TechPaula/LT6502b/Images/PCB_MidAssembly.jpg

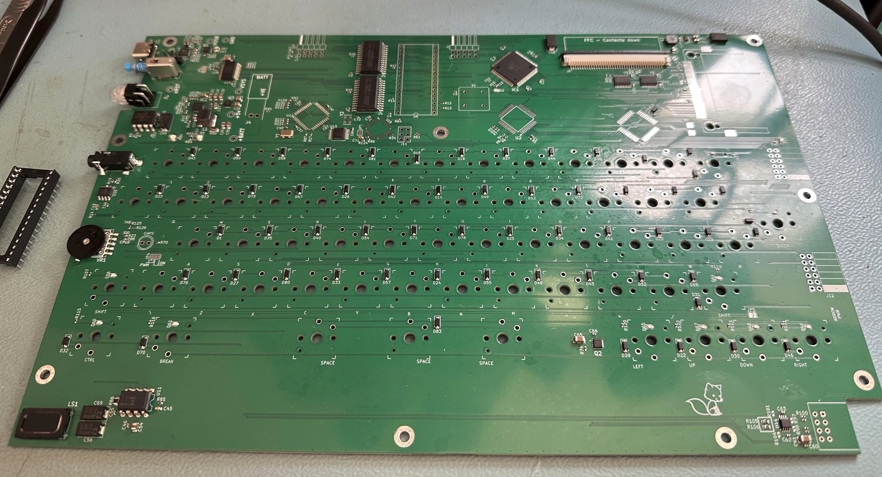
Images/PCB_MidAssembly.jpg
