TechPaula/LT6502b/Schematics/MainBoard/production/JLC_Selected_bom.xls

Comment | Designator | Footprint | JLCPCB Part #
3K3 | R1,R10,R100,R103,R16,R17,R18,R2,R21,R22,R25,R26,R27,R28,R3,R4,R5,R6,R64,R7,R8,R87,R92 | 0402 | C25890
47nF | C55 | 0402 | C82219
1K8 | R102,R91,R99 | 0402 | C25871
330R | R107,R115,R116,R117,R118,R119,R120,R121,R122,R123,R29 | 0402 | C25104
Conn_02x20_Odd_Even | J5 | GCT_FFC3B07-40-T | C501492
2.2uF25V | C27 | 0805 | C19110
10K | R108,R109,R11,R110,R111,R112,R113,R114,R12,R13,R37,R54,R57,R71,R72,R73,R82,R85,R93,R94 | 0402 | C25744
100K | R50,R74,R83 | 0402 | C25741
ECS-3961-200-AU-TR | Y1 | ECS3961200AUTR | C2451088
10K5 | R42,R43,R44,R45 | 0402 | C25850
220nF | C43 | 0603 | C21120
27K | R48 | 0402 | C2933084
100nF | C15,C1,C10,C11,C12,C13,C14,C18,C2,C28,C3,C35,C36,C37,C38,C39,C4,C40,C42,C44,C46,C47,C48,C49,C5,C50,C51,C52,C53,C6,C60,C62,C63,C64,C66,C67,C68,C7,C70,C72,C8,C9 | 0402 | C307331
POWERON | D11,D18 | 0805 | C2296
100uF10VTant | C56,C57,C58,C59,C69 | CP_EIA-7343-30_AVX-N | C49332976
10uF25V | C54,C16,C22,C29,C30,C31 | 0805 | C15850
TXS0108 | U8,U9 | TSSOP-20_4.4x6.5mm_P0.65mm | C17206
MP2636GR-P | IC2 | MP2636GR | C128212
TXS0102DCT | U14 | SSOP-8_2.95x2.8mm_P0.65mm | C324082
5K1 | R30,R31,R35,R36,R39 | 0402 | C25905
74HCT138 | U15 | SSOP-16_5.3x6.2mm_P0.65mm | C8115
10R | R86 | 0805 | C844598
1uF | C21,C24 | 0603 | C15849
ESDA25W | D3 | SOT65P210X110-3N | C2935152
22K | R53,R49 | 0402 | C25768
33nF | C45 | 0603 | C21117
22uF25V | C17,C19,C20,C25,C26,C33,C34 | 0805 | C45783
470p | C71 | 0603 | C1620
1N4148W | D1,D12,D13,D14,D15,D16,D20,D22,D23,D24,D25,D26,D27,D28,D29,D30,D31,D32,D33,D34,D35,D36,D37,D38,D39,D40,D41,D42,D43,D44,D45,D46,D47,D48,D49,D50,D51,D52,D53,D54,D55,D57,D58,D59,D69,D70,D71,D72,D73,D74,D75,D76,D77,D78,D79,D80,D81,D82,D83 | D_SOD-123 | C2099
470R | R15,R70,R81 | 0402 | C25117
2K49 | R52 | 0402 | C2692737
120K | R47 | 0402 | C25750
4K7 | R125,R69 | 0402 | C25900
0.1uF25VC0G | C23,C32 | 0603 | C91183
100R | R55 | 0402 | C25076
AP63203WU | U7 | TSOT-23-6 | C780769
LED | D2,D56,D60,D61,D62,D63,D64,D65,D66,D67,D68 | 0603 | C2286
CHARGE | D9 | 0805 | C84256
240k | R96 | 0402 | C2909338
44K2 | R41 | 0402 | C11565
4.7uH | L2 | NRS5020T220MMGJV | C2762047
BAT60A | D4 | D_SOD-323 | C5355496
1K | R19,R20,R58,R59,R60,R65,R66,R76,R77,R78,R79,R80,R9,R90 | 0402 | C11702
47uF | C41,C61,C65 | 1206 | C96123
47K | R23,R88 | 0402 | C25792
IS62C256AL | U3,U4 | SOP-28_8.4x18.16mm_P1.27mm | C14323
6K8 | R51,R84 | 0402 | C25917
STL9P3LLH6 | Q1,Q2,Q3 | STL20N6F7 | C2969828
40mR | R56 | 1206 | C2774938
15K | R40,R46 | 0402 | C25756
0R | R105,R106 | 0603 | C21189
1K | R33 | 0603 | C21190
STUSB4500QTR | U6 | QFN-24-1EP_4x4mm_P0.5mm_EP2.7x2.7mm | C2678061
