TechPaula/LT6502b/Schematics/Keybed/Assembly/Keybed_JLC_assembly_parts_bom.xls

Comment | Designator | Footprint | JLCPCB Part #
3K3 | R7 | 0603 | C22978
10K | R1 | 0603 | C25804
100nF | C1,C2,C4,C5,C8,C98,C99 | 0805 | C49678
1N4148W | D1,D10,D11,D12,D13,D14,D15,D16,D17,D18,D19,D2,D20,D21,D22,D23,D24,D25,D26,D27,D28,D29,D3,D30,D31,D32,D33,D34,D35,D36,D37,D38,D39,D4,D40,D41,D42,D43,D44,D45,D46,D47,D48,D49,D5,D50,D51,D52,D53,D54,D55,D57,D58,D59,D6,D7,D8,D9 | D_SOD-123 | C2099
47uF | C3,C6 | 1206 | C96123
470R | R2 | 0603 | C23179
74HCT138 | U2 | SSOP-16_5.3x6.2mm_P0.65mm | C8115
LED | D56,D60,D61,D62,D63,D64,D65,D66,D67,D68,D69 | 0603 | C2286
330R | R10,R11,R12,R13,R14,R3,R4,R5,R6,R8,R9 | 0603 | C23138
STL9P3LLH6 | Q3 | STL20N6F7 | C2969828
100K | R83 | 0402 | C25741
