TechPaula/LT6502b/Schematics/MainBoard/MainBoard_full_BoM.xls

Sheet: JLC FITTED
Comment | Designator | Footprint | QTY | JLCPCB Part #
3K3 | R1,R10,R100,R103,R16,R17,R18,R2,R21,R22,R25,R26,R27,R28,R3,R4,R5,R6,R64,R7,R8,R87,R92 | 0402 | 23 | C25890
47nF | C55 | 0402 | 1 | C82219
1K8 | R102,R91,R99 | 0402 | 3 | C25871
330R | R107,R115,R116,R117,R118,R119,R120,R121,R122,R123,R29 | 0402 | 11 | C25104
Conn_02x20_Odd_Even | J5 | GCT_FFC3B07-40-T | 1 | C501492
2.2uF25V | C27 | 0805 | 1 | C19110
10K | R108,R109,R11,R110,R111,R112,R113,R114,R12,R13,R37,R54,R57,R71,R72,R73,R82,R85,R93,R94 | 0402 | 20 | C25744
100K | R50,R74,R83 | 0402 | 3 | C25741
ECS-3961-200-AU-TR | Y1 | ECS3961200AUTR | 1 | C2451088
10K5 | R42,R43,R44,R45 | 0402 | 4 | C25850
220nF | C43 | 0603 | 1 | C21120
27K | R48 | 0402 | 1 | C2933084
100nF | C15,C1,C10,C11,C12,C13,C14,C18,C2,C28,C3,C35,C36,C37,C38,C39,C4,C40,C42,C44,C46,C47,C48,C49,C5,C50,C51,C52,C53,C6,C60,C62,C63,C64,C66,C67,C68,C7,C70,C72,C8,C9 | 0402 | 42 | C307331
POWERON | D11,D18 | 0805 | 2 | C2296
100uF10VTant | C56,C57,C58,C59,C69 | CP_EIA-7343-30_AVX-N | 5 | C49332976
10uF25V | C54,C16,C22,C29,C30,C31 | 0805 | 6 | C15850
TXS0108 | U8,U9 | TSSOP-20_4.4x6.5mm_P0.65mm | 2 | C17206
MP2636GR-P | IC2 | MP2636GR | 1 | C128212
TXS0102DCT | U14 | SSOP-8_2.95x2.8mm_P0.65mm | 1 | C324082
22K | R53,R49 | 0402 | 2 | C31850
5K1 | R30,R31,R35,R36,R39 | 0402 | 5 | C25905
74HCT138 | U15 | SSOP-16_5.3x6.2mm_P0.65mm | 1 | C8115
10R | R86 | 0805 | 1 | C844598
1uF | C21,C24 | 0603 | 2 | C15849
ESDA25W | D3 | SOT65P210X110-3N | 1 | C2935152
33nF | C45 | 0603 | 1 | C21117
22uF25V | C17,C19,C20,C25,C26,C33,C34 | 0805 | 7 | C45783
470p | C71 | 0603 | 1 | C1620
1N4148W | D1,D12,D13,D14,D15,D16,D20,D22,D23,D24,D25,D26,D27,D28,D29,D30,D31,D32,D33,D34,D35,D36,D37,D38,D39,D40,D41,D42,D43,D44,D45,D46,D47,D48,D49,D50,D51,D52,D53,D54,D55,D57,D58,D59,D69,D70,D71,D72,D73,D74,D75,D76,D77,D78,D79,D80,D81,D82,D83 | D_SOD-123 | 59 | C2099
470R | R15,R70,R81 | 0402 | 3 | C25117
2K49 | R52 | 0402 | 1 | C2692737
120K | R47 | 0402 | 1 | C25750
4K7 | R125,R69 | 0402 | 2 | C25900
0.1uF25VC0G | C23,C32 | 0603 | 2 | C91183
100R | R55 | 0402 | 1 | C25076
AP63203WU | U7 | TSOT-23-6 | 1 | C780769
LED | D2,D56,D60,D61,D62,D63,D64,D65,D66,D67,D68 | 0603 | 11 | C2286
CHARGE | D9 | 0805 | 1 | C84256
240k | R96 | 0402 | 1 | C2909338
44K2 | R41 | 0402 | 1 | C11565
4.7uH | L2 | NRS5020T220MMGJV | 1 | C2762047
BAT60A | D4 | D_SOD-323 | 1 | C5355496
1K | R19,R20,R58,R59,R60,R65,R66,R76,R77,R78,R79,R80,R9,R90 | 0402 | 14 | C11702
47uF | C41,C61,C65 | 1206 | 3 | C96123
47K | R23,R88 | 0402 | 2 | C25792
IS62C256AL | U3,U4 | SOP-28_8.4x18.16mm_P1.27mm | 2 | C14323
6K8 | R51,R84 | 0402 | 2 | C25917
STL9P3LLH6 | Q1,Q2,Q3 | STL20N6F7 | 3 | C2969828
40mR | R56 | 1206 | 1 | C2774938
15K | R40,R46 | 0402 | 2 | C25756
0R | R105,R106 | 0603 | 2 | C21189
1K | R33 | 0603 | 1 | C21190
STUSB4500QTR | U6 | QFN-24-1EP_4x4mm_P0.5mm_EP2.7x2.7mm | 1 | C2678061

Sheet: To Source
Designator | Description | Footprint | QTY | do I have? | MFR | MFR Part | Supplier | Supplier Part | Notes
U18 | ATmega88PA-AU | TQFP-32_7x7mm_P0.8mm | 1 | OO | Microchip | ATmega88PA-AU | AMI64 |  | NanoSwin SID
U12 | ATmega644P-20A | TQFP-44_10x10mm_P0.8mm | 1 | OO | Microchip | ATmega644P-20A
U10 | FT245RNL | SSOP-28_5.3x10.2mm_P0.65mm | 1 | 1 | FTDI | FT245RNL
U11 | LM386 | DIP-8_W7.62mm | 1 | 1 | TI | LM386N-4/NOPB
R124 | 2.2k | 0402 | 1 | 1
X1 | 28.4322MHz | Oscillator_DIP-8 | 1 | OO | ECS | ECS-2100AX-283.2
U16 | MCP6022 | SOIC-8_3.9x4.9mm_P1.27mm | 1 | OO | Microchip | MCP6022T-I/SN
Y2 | ECS-3961-320-AU-TR | ECS3961200AUTR | 1 | OO | ECS | ECS-3961-320-AU-TR
VR1 | RK10J12R0A0B | RK10J12R0A0B | 1 | 1 | Alps | RK10J12R0A0B
U13 | ESP8266-01_ESP-01 | XCVR_ESP8266-01_ESP-01 | 1 | 2 |  |  |  |  | ESP-01 (os ESP-01S) programmed with https://github.com/dhansel/WifiModem
U5 | SST39SF010A-70-4C-PHE | DIP-32 | 1 | OO | Microchip | SST39SF010A-70-4C-PHE |  |  | +Socket
D10 | Amber LED | LED_SMD:LED_0805_2012Metric | 1 | 1
D17 | Caps Lock LED | LED_THT:LED_D5.0mm | 1 | 1
IC1 | ATF1508AS-7AX100 | ATF1508ASL-nnAU100:QFP50P1600X1600X120-100N | 1 | 1 | Miceochip | ATF1508AS-7AX100 | Mouser | 556-AF1508AS7AX100
IC3 | W65C22S6TQG-14 | W65C22S6TQG-14:QFP80P1320X1320X270-44N | 1 | 1 | WDC | W65C22S6TQG-14 | Mouser | 955-W65C22S6TQG-14
J3 | USB_C_Receptacle_USB2.0_16P | Connector_USB:USB_C_Receptacle_HCTL_HC-TYPE-C-16P-01A | 1 | 1 | SameSky |  | Mouser
J4 | BATTERY JST PH-2A | S2B-XH-A_LF__SN_:SHDRRA2W80P0X250_1X2_740X1150X610P | 1 | OO |  |  | Mouser | 306-S2B-XH-ALFSN
J6 | AudioJack3 | Connector_Audio:Jack_3.5mm_CUI_SJ-3524-SMT_Horizontal | 1 | OO | SameSky | SJ-3524-SMT-TR | Mouser | 490-SJ-3524-SMT-TR
L1 | 1.5uH | SRN6045HA-1R5Y:INDPM6060X470N | 1 | 1 | Bournes | SRN6045HA-1R5Y | Mouser | 652-SRN6045HA-1R5Y
LS1 | CMS-160925-078SP-67 | CMS-160925-078SP-67:CMS160925078SP67 | 1 | 1 | Sky |  | Mouser | 490-CMS160925078SP67
R14, R32, R67, R68, R75, R95 | 0R 0402 | Resistor_SMD:R_0402_1005Metric | 6 | 6
R24, R61-R63 | 0R 0603 | Resistor_SMD:R_0603_1608Metric | 4 | 4
S1 | LC1258EENP |  | 1 | 1 | Eswitch | LC1258EENP | Mouser | 612-LC1258EENP | Power Switch
S2 | TL1250F180RQRCLR |  | 1 | 1 | Eswitch | TL1250F180RQRCLR | Mouser | 612-TL1250F180RQRCLR
SW1-SW55, SW57-SW61, SW65 | Kailh Choc Key switch |  | 61 | 9 |  |  |  |  | Also need suitable keycaps
U1 | TC1232 | Package_DIP:DIP-8_W7.62mm_LongPads | 1 | 1 | Microchip | TC1232 | Mouser | 579-TC1232CPA
U2 | W65C02S6TQG-14 | W65C22S6TQG-14:QFP80P1320X1320X270-44N | 1 | 1 | WDC | W65C02S6TQG-14 | Mouser | 955-W65C02S6TQG-14
J8 | Compact Flash connector |  | 1 | 1 |  | 693120035011 | Mouser | 598-693120035011
VR1 | Alps |  | 1 | 1 | Alps | RK10J12R0A0B | Mouser | 688-RK10J12R0A0B
