TechPaula/LT6502b/Case/Models/Lower Case V9.step

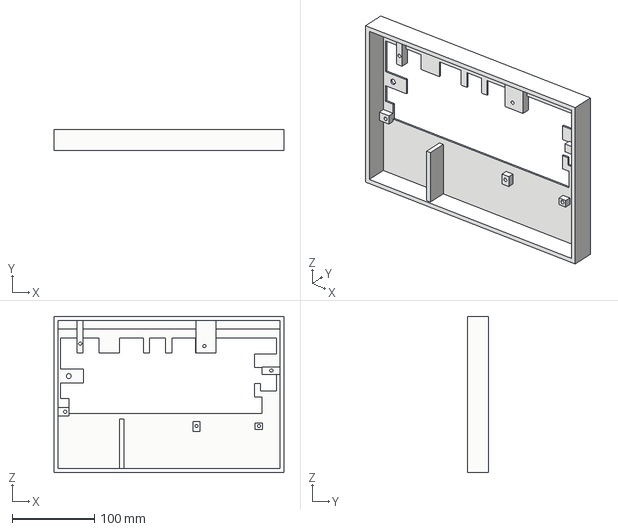
[picture p2: CAD file, 2026-02-22]
Case/Models/Lower Case V9.step
280.0 x 26.0 x 190.0 mm
