TechPaula/LT6502b/Case/Models/18650 Battery.STEP

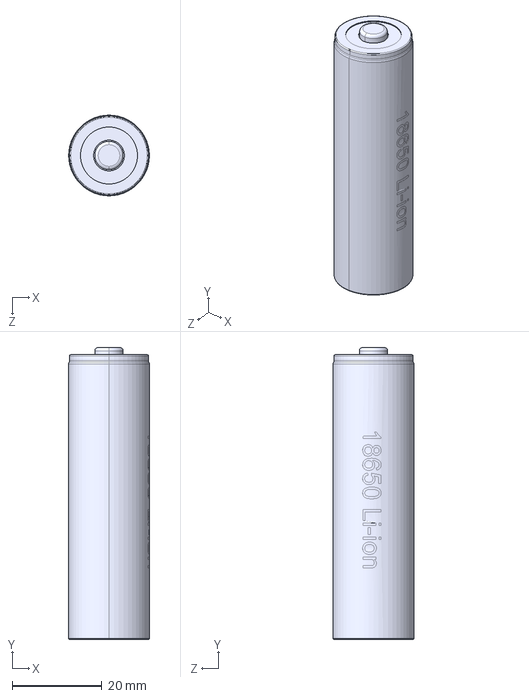
[picture p3: CAD file, 2026-02-22]
Case/Models/18650 Battery.STEP
18.0 x 65.1 x 18.0 mm
