TechPaula/LT6502b/Images/LT6502b_Assembly_2026-Feb-27.png

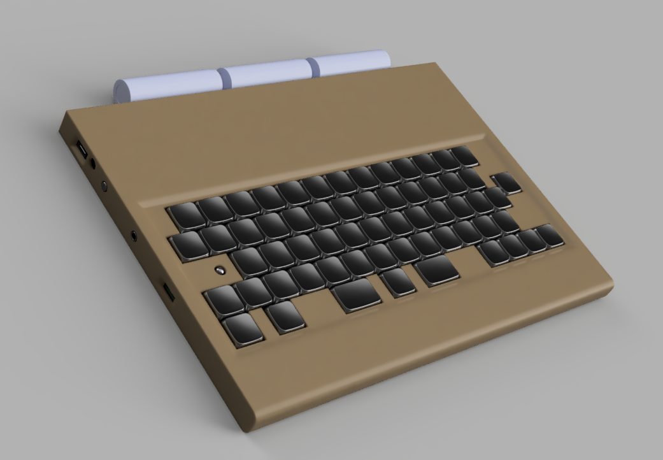
Images/LT6502b_Assembly_2026-Feb-27.png
