TechPaula/LT6502b/Images/LT6502b_Assembly_2026-Mar-07_08-01_noHinge.png

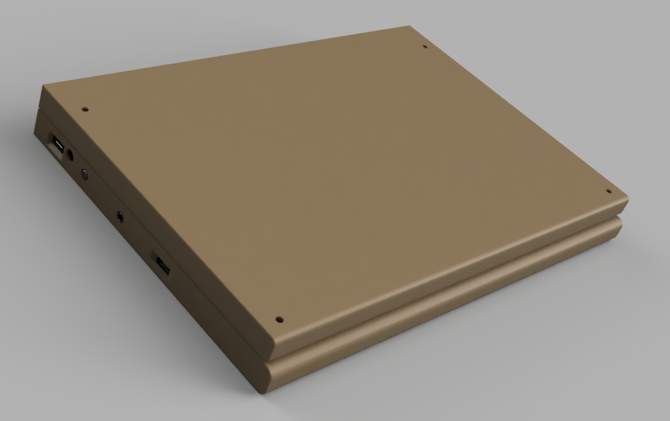
Images/LT6502b_Assembly_2026-Mar-07_08-01_noHinge.png
