TechPaula/LT6502b/Case/Dimensions for main PCB.pdf

1

A

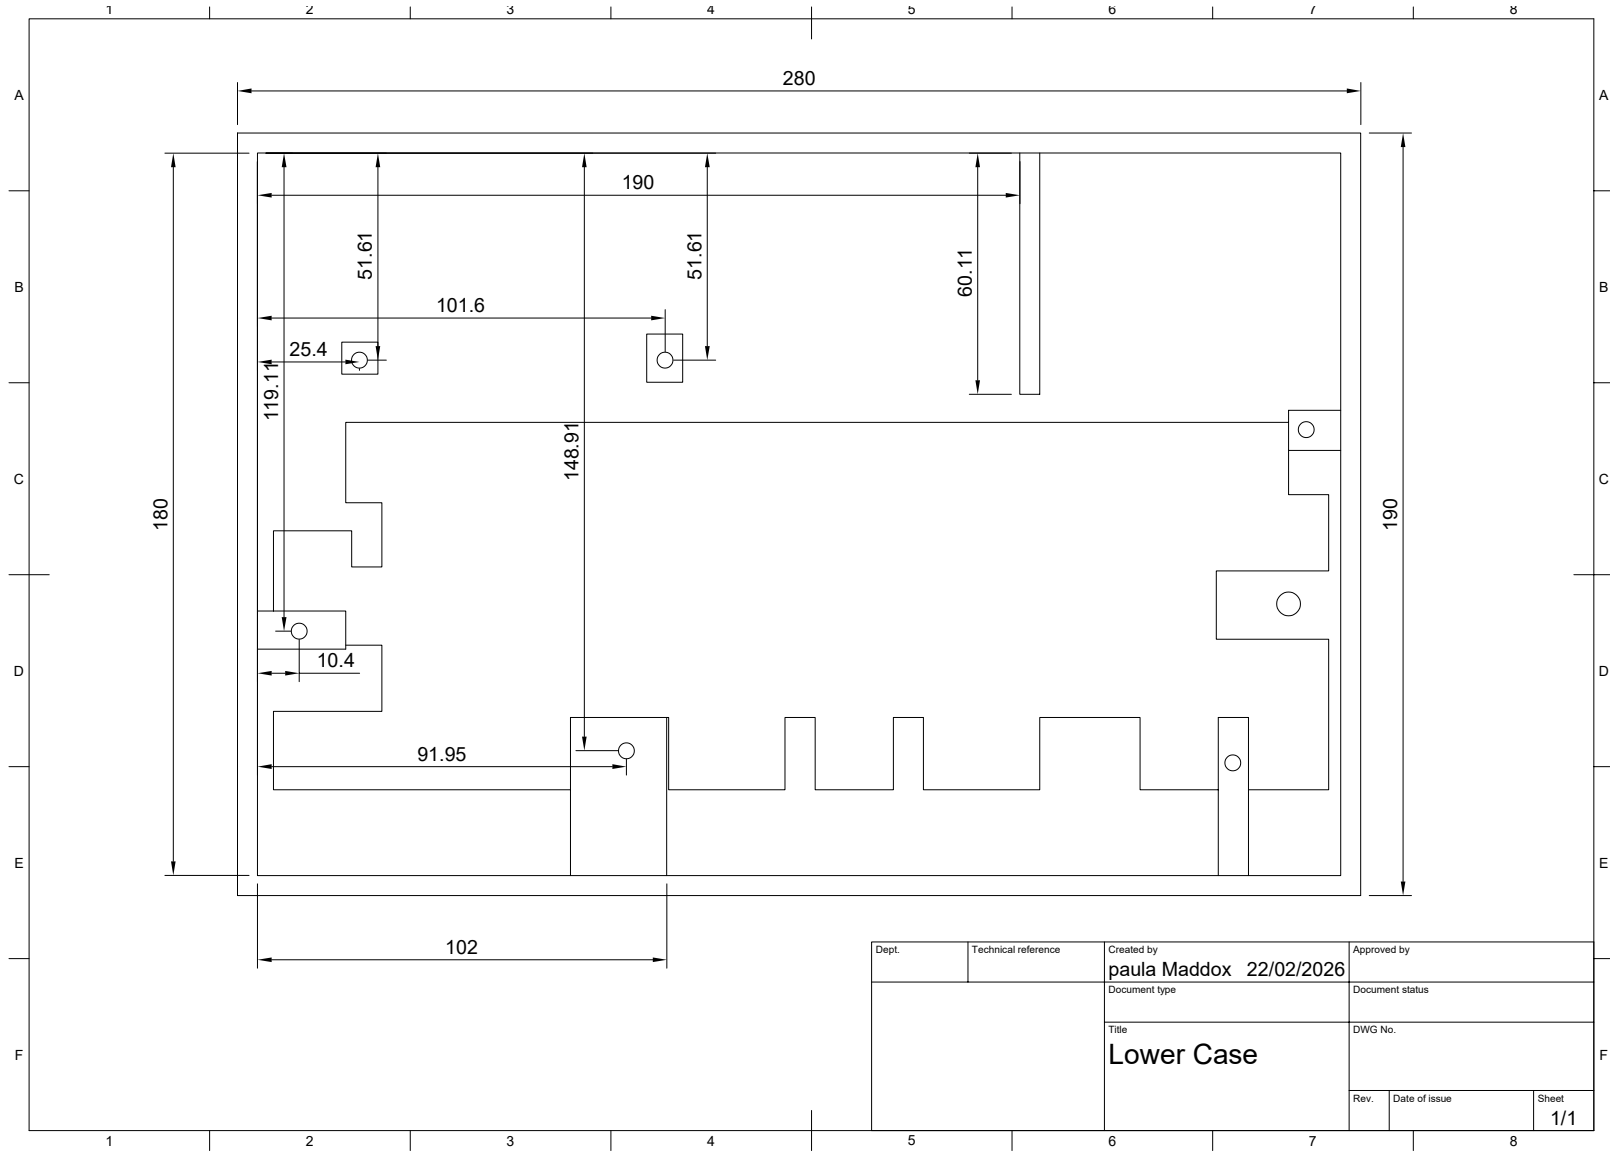
[picture p6: page 1]
Dept.; Technical reference; Created by; Approved by; Document type; Document status; Title; DWG No.; Rev.; Date of issue; Sheet; Lower Case; paula Maddox; 10.4 ¹¹⁹.11
