TechPaula/LT6502b/Schematics/MainBoard/MainBoard.kicad_pcb

## KiCad design Schematics/MainBoard/MainBoard.kicad_pcb (2026-02-24)

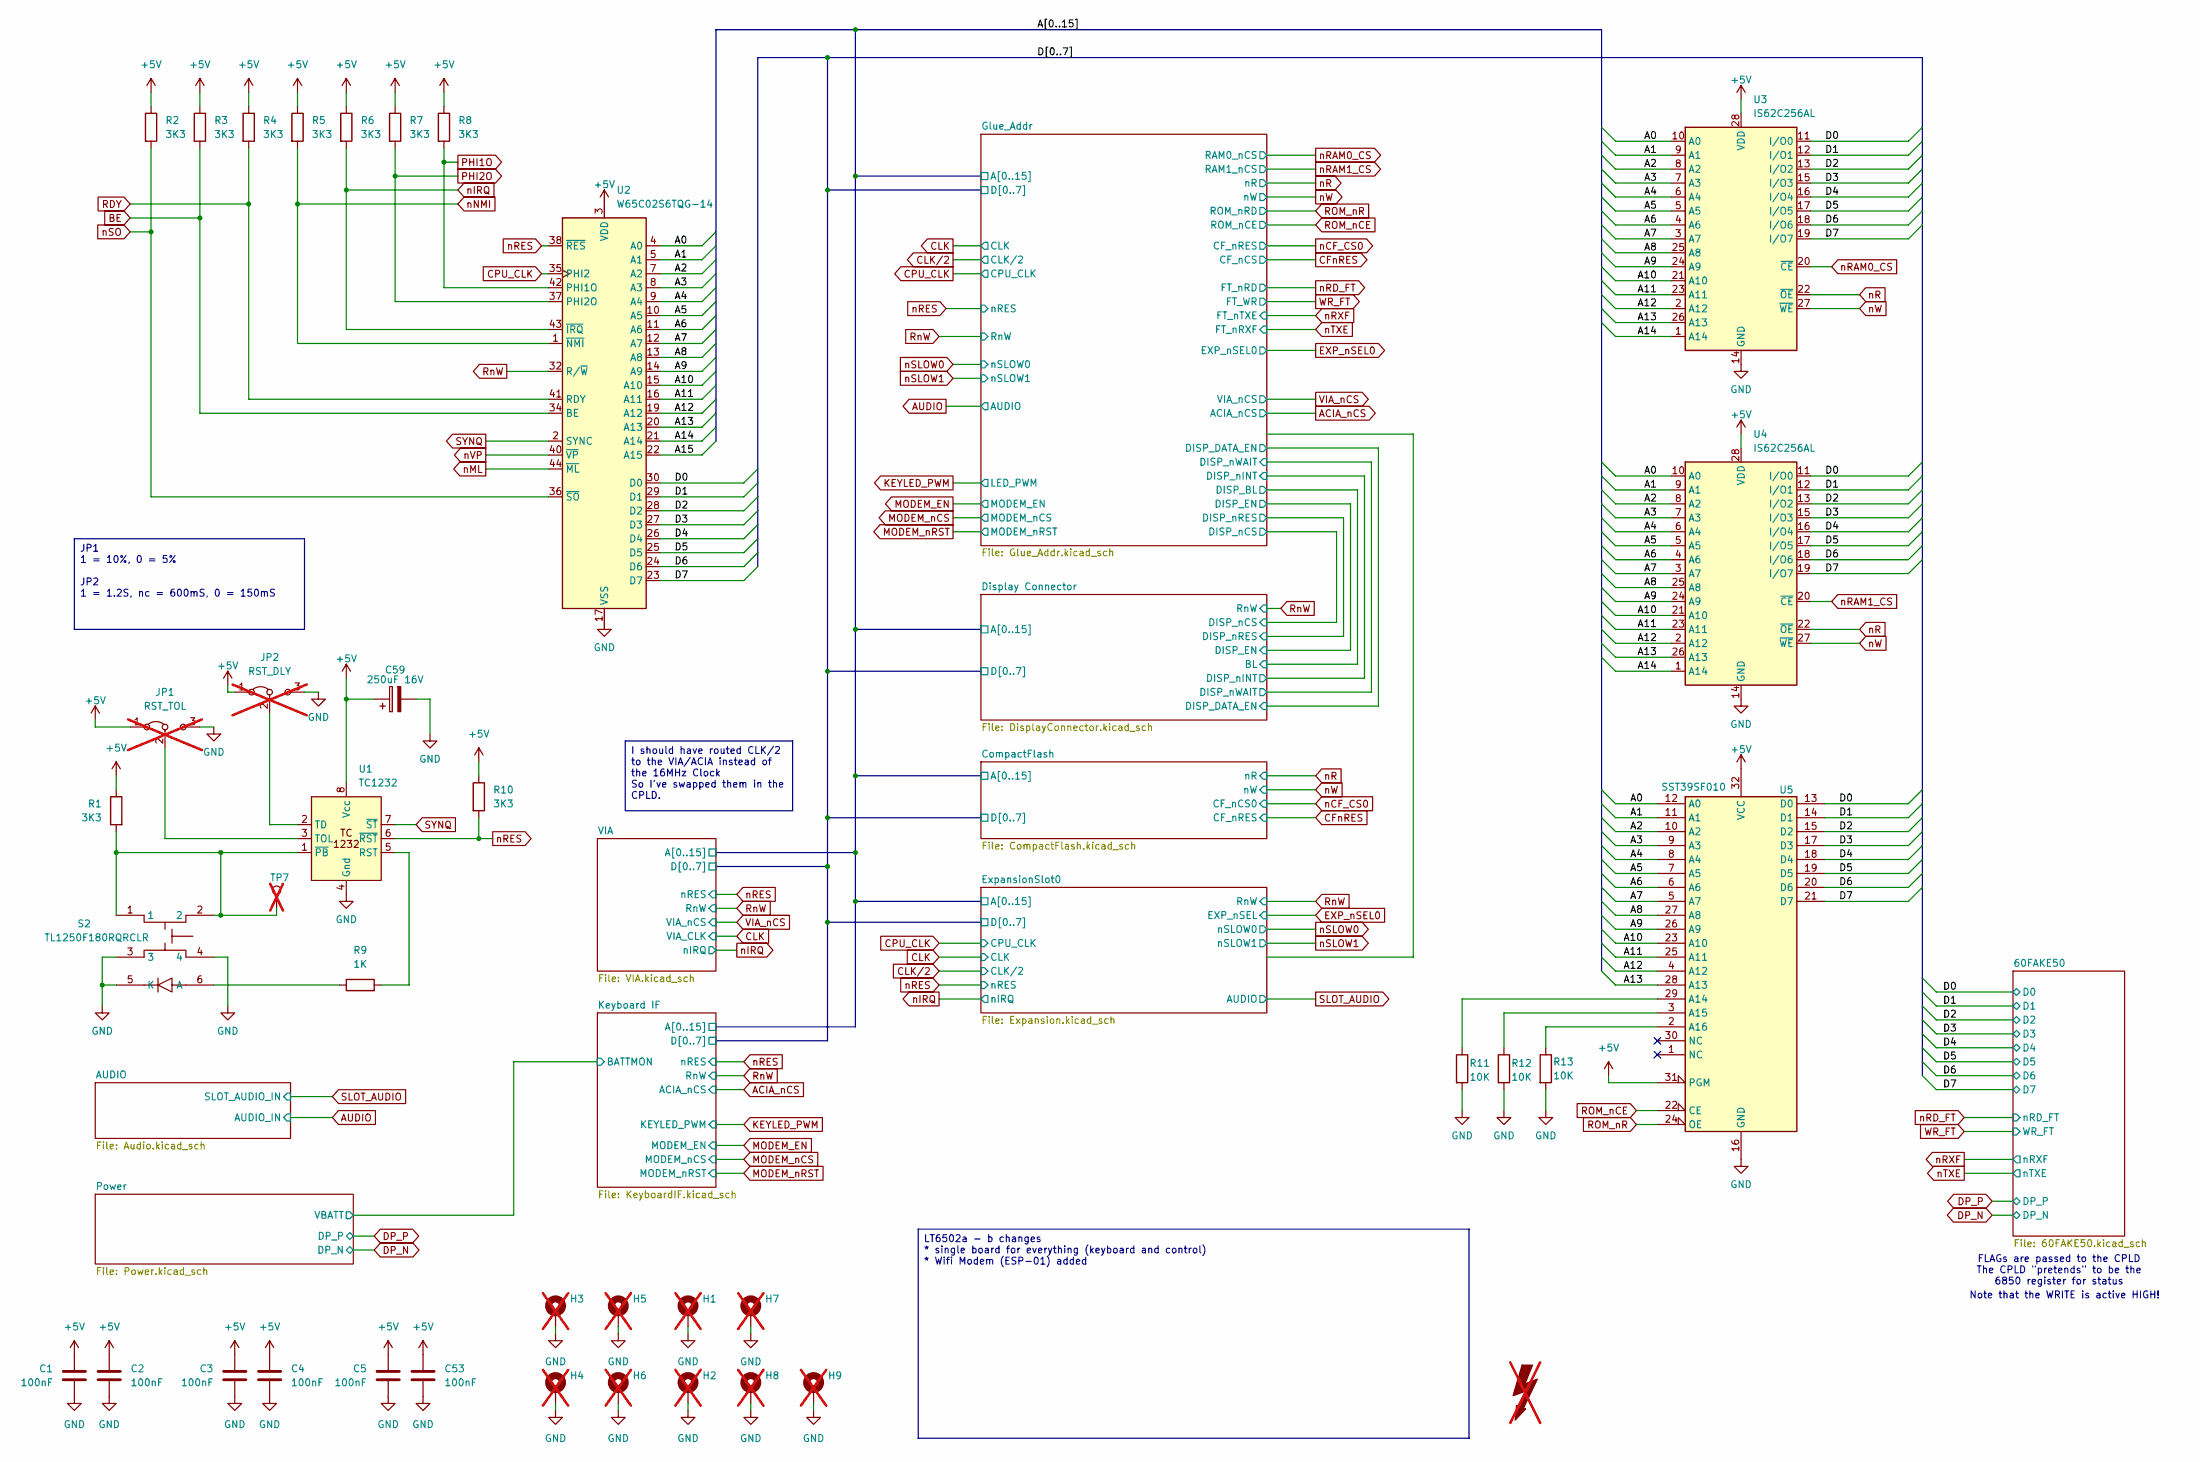
[picture p7: schematic MainBoard.kicad_sch]

Parts:
C1, C2, C3, C4, C5, C53: 100nF; C_0603_1608Metric; LCSC C113803
C59: 250uF 16V; CP_Elec_10x12.5; Mouser Part Number 667-EEV-FK1V681Q
FOX1: SYM_Flash_Large; Fox_avatar_18mm; LCSC DNF; not fitted
H1, H2, H3, H4, H5, H6, H7, H8, H9: MountingHole_Pad; MountingHole_3.2mm_M3_Pad_TopBottom; LCSC DNF; not fitted
JP1: RST_TOL; SolderJumper-3_P1.3mm_Bridged12_Pad1.0x1.5mm_NumberLabels; LCSC DNF; not fitted
JP2: RST_DLY; SolderJumper-3_P1.3mm_Bridged12_Pad1.0x1.5mm_NumberLabels; LCSC DNF; not fitted
R1, R2, R3, R4, R5, R6, R7, R8, R10: 3K3; R_0402_1005Metric; LCSC C25890
R9: 1K; R_0402_1005Metric; LCSC C11702
R11, R12, R13: 10K; R_0402_1005Metric; LCSC C25744
S2: TL1250F180RQRCLR; Mouser Part Number 612-TL1250F180RQRCLR
TP7: TestPoint; TestPoint_Loop_D1.80mm_Drill1.0mm_Beaded; LCSC DNF; not fitted
U1: TC1232; DIP-8_W7.62mm_LongPads; Mouser Part Number 579-TC1232CPA
U2: W65C02S6TQG-14; QFP80P1320X1320X270-44N; Mouser Part Number 955-W65C02S6TQG-14
U3, U4: IS62C256AL; SOP-28_8.4x18.16mm_P1.27mm; Mouser Part Number 870-62C256AL-25ULIT
U5: SST39SF010; DIP-32_W15.24mm_Socket; LCSC DNF

Connections:
+5V: C1.1, C2.1, C3.1, C4.1, C5.1, C53.1, C59.1, JP1.1 (A), JP2.1 (A), R1.1, R2.1, R3.1, R4.1, R5.1, R6.1, R7.1, R8.1, R10.1, U1.8 (Vcc), U2.3 (VDD), U2.31 (VDD), U3.28 (VDD), U4.28 (VDD), U5.31 (PGM), U5.32 (VCC); also elsewhere on the board
/A0: U2.4 (A0), U3.10 (A0), U4.10 (A0), U5.12 (A0); also elsewhere on the board
/A1: U2.5 (A1), U3.9 (A1), U4.9 (A1), U5.11 (A1); also elsewhere on the board
/A2: U2.7 (A2), U3.8 (A2), U4.8 (A2), U5.10 (A2); also elsewhere on the board
/A3: U2.8 (A3), U3.7 (A3), U4.7 (A3), U5.9 (A3); also elsewhere on the board
/A4: U2.9 (A4), U3.6 (A4), U4.6 (A4), U5.8 (A4); also elsewhere on the board
/A5: U2.10 (A5), U3.5 (A5), U4.5 (A5), U5.7 (A5); also elsewhere on the board
/A6: U2.11 (A6), U3.4 (A6), U4.4 (A6), U5.6 (A6); also elsewhere on the board
/A7: U2.12 (A7), U3.3 (A7), U4.3 (A7), U5.5 (A7); also elsewhere on the board
/A8: U2.13 (A8), U3.25 (A8), U4.25 (A8), U5.27 (A8); also elsewhere on the board
/A9: U2.14 (A9), U3.24 (A9), U4.24 (A9), U5.26 (A9); also elsewhere on the board
/A10: U2.15 (A10), U3.21 (A10), U4.21 (A10), U5.23 (A10); also elsewhere on the board
/A11: U2.16 (A11), U3.23 (A11), U4.23 (A11), U5.25 (A11); also elsewhere on the board
/A12: U2.19 (A12), U3.2 (A12), U4.2 (A12), U5.4 (A12); also elsewhere on the board
/A13: U2.20 (A13), U3.26 (A13), U4.26 (A13), U5.28 (A13); also elsewhere on the board
/A14: U2.21 (A14), U3.1 (A14), U4.1 (A14); also elsewhere on the board
/A15: U2.22 (A15); also elsewhere on the board
/D0: U2.30 (D0), U3.11 (I/O0), U4.11 (I/O0), U5.13 (D0); also elsewhere on the board
/D1: U2.29 (D1), U3.12 (I/O1), U4.12 (I/O1), U5.14 (D1); also elsewhere on the board
/D2: U2.28 (D2), U3.13 (I/O2), U4.13 (I/O2), U5.15 (D2); also elsewhere on the board
/D3: U2.27 (D3), U3.15 (I/O3), U4.15 (I/O3), U5.17 (D3); also elsewhere on the board
/D4: U2.26 (D4), U3.16 (I/O4), U4.16 (I/O4), U5.18 (D4); also elsewhere on the board
/D5: U2.25 (D5), U3.17 (I/O5), U4.17 (I/O5), U5.19 (D5); also elsewhere on the board
/D6: U2.24 (D6), U3.18 (I/O6), U4.18 (I/O6), U5.20 (D6); also elsewhere on the board
/D7: U2.23 (D7), U3.19 (I/O7), U4.19 (I/O7), U5.21 (D7); also elsewhere on the board
BE: R3.2, U2.34 (BE)
CPU_CLK: U2.35 (PHI2); also elsewhere on the board
GND: C1.2, C2.2, C3.2, C4.2, C5.2, C53.2, C59.2, H1.1, H2.1, H3.1, H4.1, H5.1, H6.1, H7.1, H8.1, H9.1, JP1.3 (B), JP2.3 (B), R11.2, R12.2, R13.2, S2.3, S2.4, S2.5 (K), U1.4 (Gnd), U2.17 (VSS), U2.18 (VSS), U2.39 (VSS), U3.14 (GND), U4.14 (GND), U5.16 (GND); also elsewhere on the board
unnamed: JP1.2 (C), U1.3 (TOL)
unnamed: JP2.2 (C), U1.2 (TD)
unnamed: R9.1, S2.6 (A)
unnamed: R9.2, U1.5 (RST)
unnamed: R1.2, S2.1, S2.2, TP7.1, U1.1 (~PB)
unnamed: R11.1, U5.29 (A14)
unnamed: R12.1, U5.3 (A15)
unnamed: R13.1, U5.2 (A16)
PHI1O: R8.2, U2.42 (PHI1O)
PHI2O: R7.2, U2.37 (PHI2O)
RDY: R4.2, U2.41 (RDY)
ROM_nCE: U5.22 (CE); also elsewhere on the board
ROM_nR: U5.24 (OE); also elsewhere on the board
RnW: U2.32 (R/~W); also elsewhere on the board
SYNQ: U1.7 (~ST), U2.2 (SYNC)
nIRQ: R6.2, U2.43 (~IRQ); also elsewhere on the board
nML: U2.44 (~ML)
nNMI: R5.2, U2.1 (~NMI)
nR: U3.22 (~OE), U4.22 (~OE); also elsewhere on the board
nRAM0_CS: U3.20 (~CE); also elsewhere on the board
nRAM1_CS: U4.20 (~CE); also elsewhere on the board
nRES: R10.2, U1.6 (~RST), U2.38 (~RES); also elsewhere on the board
nSO: R2.2, U2.36 (~SO)
nVP: U2.40 (~VP)
nW: U3.27 (~WE), U4.27 (~WE); also elsewhere on the board

Notes on the sheet:
FLAGs are passed to the CPLD The CPLD "pretends" to be the 6850 register for status
Note that the WRITE is active HIGH!
JP1 1 = 10%, 0 = 5% JP2 1 = 1.2S, nc = 600mS, 0 = 150mS
I should have routed CLK/2 to the VIA/ACIA instead of the 16MHz Clock So I've swapped them in the CPLD.
LT6502a - b changes * single board for everything (keyboard and control) * Wifi Modem (ESP-01) added

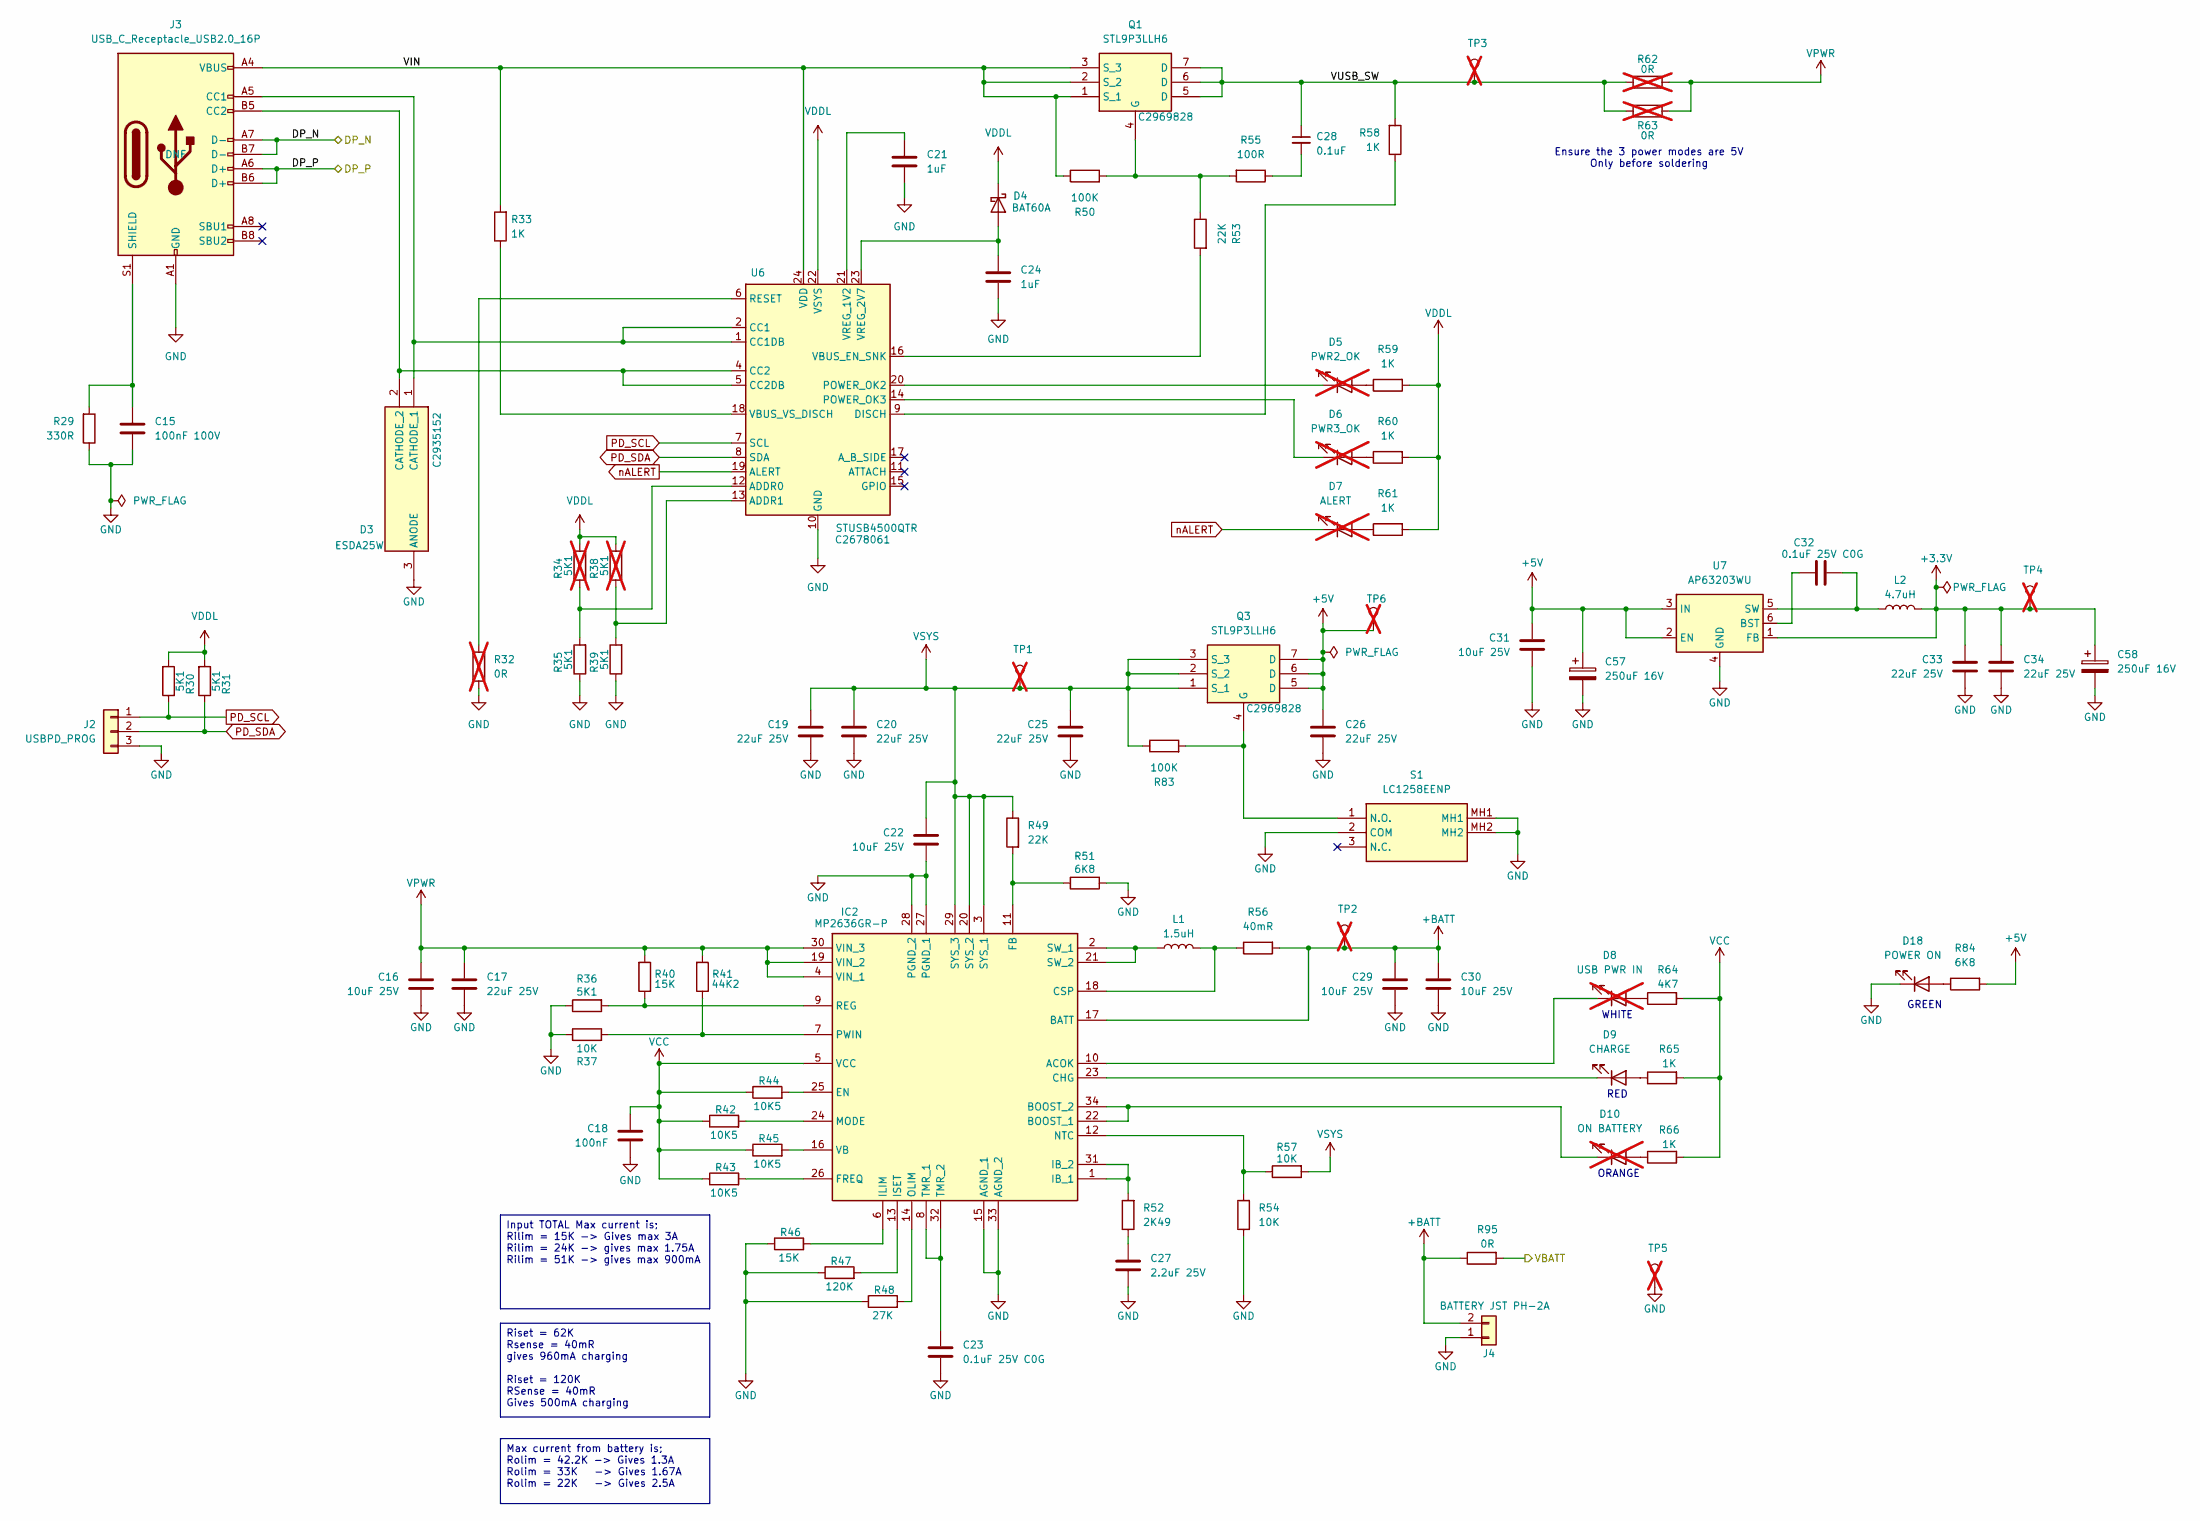
[picture p8: schematic Power.kicad_sch]

Parts:
C15: 100nF 100V; C_0603_1608Metric; LCSC C113803
C16, C22, C29, C30, C31: 10uF 25V; C_0805_2012Metric; LCSC C15850
C17, C19, C20, C25, C26, C33, C34: 22uF 25V; C_0805_2012Metric; LCSC C45783
C18: 100nF; C_0603_1608Metric; LCSC C113803
C21, C24: 1uF; C_0603_1608Metric; LCSC C15849
C23, C32: 0.1uF 25V C0G; C_0603_1608Metric; LCSC C91183
C27: 2.2uF 25V; C_0805_2012Metric; LCSC C19110
C28: 0.1uF; C_0603_1608Metric; LCSC C113803
C57, C58: 250uF 16V; CP_Elec_10x12.5; Mouser Part Number 667-EEV-FK1V681Q
D3: ESDA25W; SOT65P210X110-3N; Mouser Part Number 511-ESDA25W
D4: BAT60A; D_SOD-323; LCSC C5355496
D5: PWR2_OK; LED_0603_1608Metric; LCSC DNF; not fitted
D6: PWR3_OK; LED_0603_1608Metric; LCSC DNF; not fitted
D7: ALERT; LED_0603_1608Metric; LCSC DNF; not fitted
D8: USB PWR IN; LED_0805_2012Metric; LCSC DNF; not fitted
D9: CHARGE; LED_0805_2012Metric; LCSC DNF
D10: ON BATTERY; LED_0805_2012Metric; LCSC DNF; not fitted
D18: POWER ON; LED_0805_2012Metric; LCSC DNF
IC2: MP2636GR-P; MP2636GR; Mouser Part Number 946-MP2636GR-P
J2: USBPD_PROG; PinHeader_1x03_P2.54mm_Vertical; LCSC DNF
J3: USB_C_Receptacle_USB2.0_16P; USB_C_Receptacle_HCTL_HC-TYPE-C-16P-01A; LCSC DNF
J4: BATTERY JST PH-2A; SHDRRA2W80P0X250_1X2_740X1150X610P; Mouser Part Number 306-S2B-XH-ALFSN
L1: 1.5uH; INDPM6060X470N; Mouser Part Number 652-SRN6045HA-1R5Y
L2: 4.7uH; NRS5020T220MMGJV; Mouser Part Number 963-NRS5020T4R7MMGJ
Q1, Q3: STL9P3LLH6; STL20N6F7; Manufacturer_Part_Number STL9P3LLH6; Mouser Part Number 511-STL9P3LLH6
R29: 330R; R_0402_1005Metric; LCSC C25104
R30, R31, R35, R36, R39: 5K1; R_0402_1005Metric; LCSC C25905
R32: 0R; R_0402_1005Metric; LCSC DNF; not fitted
R33, R58, R59, R60, R61, R65, R66: 1K; R_0402_1005Metric; LCSC C11702
R34, R38: 5K1; R_0402_1005Metric; LCSC C25905; not fitted
R37, R54, R57: 10K; R_0402_1005Metric; LCSC C25744
R40: 15K; R_0402_1005Metric; LCSC C25756
R41: 44K2; R_0402_1005Metric; LCSC C11565
R42, R43, R44, R45: 10K5; R_0402_1005Metric; LCSC C25850
R46: 15K; R_0402_1005Metric; LCSC ???
R47: 120K; R_0402_1005Metric; LCSC ???
R48: 27K; R_0402_1005Metric
R49, R53: 22K; R_0402_1005Metric; LCSC C25768
R50, R83: 100K; R_0402_1005Metric; LCSC C25741
R51: 6K8; R_0402_1005Metric; LCSC C25917
R52: 2K49; R_0402_1005Metric; LCSC C2692737
R55: 100R; R_0402_1005Metric; LCSC C25076
R56: 40mR; R_1206_3216Metric; LCSC C2774938
R62, R63: 0R; R_0603_1608Metric; LCSC DNF; not fitted
R64: 4K7; R_0402_1005Metric
R84: 6K8; R_0402_1005Metric
R95: 0R; R_0402_1005Metric
S1: LC1258EENP; Mouser Part Number 612-LC1258EENP
TP1, TP2, TP3, TP4, TP5, TP6: TestPoint; TestPoint_Loop_D1.80mm_Drill1.0mm_Beaded; LCSC DNF; not fitted
U6: STUSB4500QTR; QFN-24-1EP_4x4mm_P0.5mm_EP2.7x2.7mm; LCSC C2678061
U7: AP63203WU; TSOT-23-6; Mouser Part Number 621-AP63203WU-7

Connections:
+3.3V: C33.1, C34.1, C58.1, L2.2, TP4.1, U7.1 (FB); also elsewhere on the board
+5V: C26.1, C31.1, C57.1, Q3.5 (D), Q3.6 (D), Q3.7 (D), R84.2, TP6.1, U7.2 (EN), U7.3 (IN); also elsewhere on the board
+BATT: C29.1, C30.1, IC2.17 (BATT), J4.2, R56.2, R95.1, TP2.1
/Keyboard IF/BATTMON: R95.2; also elsewhere on the board
/Power/VIN: J3.A4 (VBUS), J3.A9 (VBUS), J3.B4 (VBUS), J3.B9 (VBUS), Q1.1 (S_1), Q1.2 (S_2), Q1.3 (S_3), R33.2, R50.1, U6.24 (VDD)
/Power/VUSB_SW: C28.1, Q1.5 (D), Q1.6 (D), Q1.7 (D), R58.2, R62.1, R63.1, TP3.1
DP_N: J3.A7 (D-), J3.B7 (D-); also elsewhere on the board
DP_P: J3.A6 (D+), J3.B6 (D+); also elsewhere on the board
GND: C15.2, C16.2, C17.2, C18.2, C19.2, C20.2, C21.2, C22.2, C23.2, C24.2, C25.2, C26.2, C27.2, C29.2, C30.2, C31.2, C33.2, C34.2, C57.2, C58.2, D3.3 (ANODE), D18.1 (K), IC2.15 (AGND_1), IC2.27 (PGND_1), IC2.28 (PGND_2), IC2.33 (AGND_2), J2.3, J3.A1 (GND), J3.A12 (GND), J3.B1 (GND), J3.B12 (GND), J4.1, R29.1, R32.1, R35.1, R36.1, R37.1, R39.1, R46.1, R47.1, R48.1, R51.2, R54.1, S1.2 (COM), S1.MH1, S1.MH2, TP5.1, U6.10 (GND), U6.25 (GND), U7.4 (GND); also elsewhere on the board
unnamed: C27.1, R52.1
unnamed: C28.2, R55.1
unnamed: D3.1 (CATHODE_1), J3.A5 (CC1), U6.1 (CC1DB), U6.2 (CC1)
unnamed: D3.2 (CATHODE_2), J3.B5 (CC2), U6.4 (CC2), U6.5 (CC2DB)
unnamed: C24.1, D4.2 (A), U6.23 (VREG_2V7)
unnamed: D5.2 (A), R59.1
unnamed: D5.1 (K), U6.20 (POWER_OK2)
unnamed: D6.2 (A), R60.1
unnamed: D6.1 (K), U6.14 (POWER_OK3)
unnamed: D7.2 (A), R61.1
unnamed: D8.2 (A), R64.1
unnamed: D8.1 (K), IC2.10 (ACOK)
unnamed: D9.2 (A), R65.1
unnamed: D9.1 (K), IC2.23 (CHG)
unnamed: D10.2 (A), R66.1
unnamed: D10.1 (K), IC2.22 (BOOST_1), IC2.34 (BOOST_2)
unnamed: D18.2 (A), R84.1
unnamed: IC2.18 (CSP), L1.2, R56.1
unnamed: IC2.25 (EN), R44.2
unnamed: IC2.11 (FB), R49.2, R51.1
unnamed: IC2.26 (FREQ), R43.2
unnamed: IC2.1 (IB_1), IC2.31 (IB_2), R52.2
unnamed: IC2.6 (ILIM), R46.2
unnamed: IC2.13 (ISET), R47.2
unnamed: IC2.24 (MODE), R42.2
unnamed: IC2.12 (NTC), R54.2, R57.1
unnamed: IC2.14 (OLIM), R48.2
unnamed: IC2.7 (PWIN), R37.2, R41.1
unnamed: IC2.9 (REG), R36.2, R40.1
unnamed: IC2.2 (SW_1), IC2.21 (SW_2), L1.1
unnamed: C23.1, IC2.8 (TMR_1), IC2.32 (TMR_2)
unnamed: IC2.16 (VB), R45.2
unnamed: C15.1, J3.S1 (SHIELD), R29.2
unnamed: Q1.4 (G), R50.2, R53.1, R55.2
unnamed: Q3.4 (G), R83.2, S1.1 (N.O.)
unnamed: R34.1, R35.2, U6.12 (ADDR0)
unnamed: R38.1, R39.2, U6.13 (ADDR1)
unnamed: R58.1, U6.9 (DISCH)
unnamed: R32.2, U6.6 (RESET)
unnamed: R53.2, U6.16 (VBUS_EN_SNK)
unnamed: R33.1, U6.18 (VBUS_VS_DISCH)
unnamed: C21.1, U6.21 (VREG_1V2)
unnamed: C32.1, U7.6 (BST)
unnamed: C32.2, L2.1, U7.5 (SW)
PD_SCL: J2.1, R30.1, U6.7 (SCL)
PD_SDA: J2.2, R31.1, U6.8 (SDA)
VCC: C18.1, IC2.5 (VCC), R42.1, R43.1, R44.1, R45.1, R64.2, R65.2, R66.2
VPWR: C16.1, C17.1, IC2.4 (VIN_1), IC2.19 (VIN_2), IC2.30 (VIN_3), R40.2, R41.2, R62.2, R63.2; also elsewhere on the board
VSYS: C19.1, C20.1, C22.1, C25.1, IC2.3 (SYS_1), IC2.20 (SYS_2), IC2.29 (SYS_3), Q3.1 (S_1), Q3.2 (S_2), Q3.3 (S_3), R49.1, R57.2, R83.1, TP1.1
nALERT: D7.1 (K), U6.19 (ALERT)

Notes on the sheet:
Ensure the 3 power modes are 5V Only before soldering
ORANGE
RED
GREEN
WHITE
Input TOTAL Max current is; Rilim = 15K -> Gives max 3A Rilim = 24K -> gives max 1.75A Rilim = 51K -> gives max 900mA
Riset = 62K Rsense = 40mR gives 960mA charging Riset = 120K RSense = 40mR Gives 500mA charging
Max current from battery is; Rolim = 42.2K -> Gives 1.3A Rolim = 33K -> Gives 1.67A Rolim = 22K -> Gives 2.5A

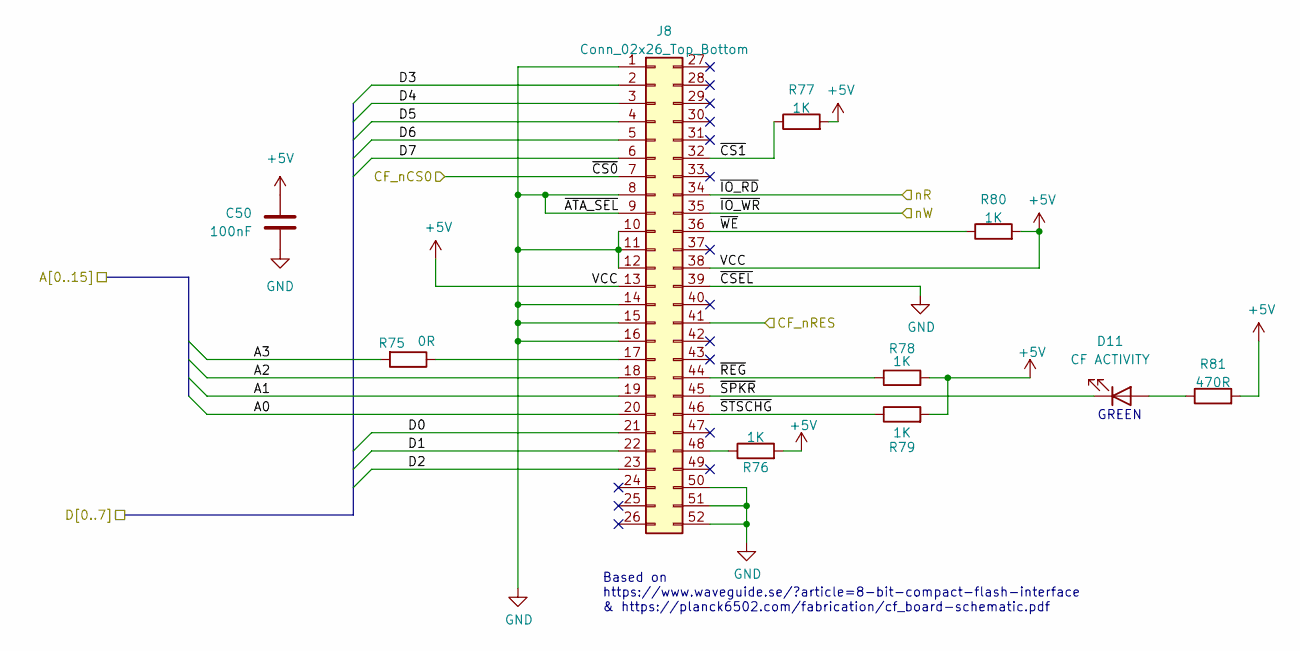
[picture p9: schematic CompactFlash.kicad_sch]

Parts:
C50: 100nF; C_0603_1608Metric; LCSC C113803
D11: CF ACTIVITY; LED_0805_2012Metric; LCSC DNF
J8: Conn_02x26_Top_Bottom; SD-SMD_CFH-L3C1LBL01MN0; Mouser Part Number 710-693120035011; LCSC DNF
R75: 0R; R_0402_1005Metric; LCSC DNF
R76, R77, R78, R79, R80: 1K; R_0402_1005Metric; LCSC C11702
R81: 470R; R_0402_1005Metric; LCSC C25117

Connections:
+5V: C50.1, J8.13, J8.38, R76.2, R77.2, R78.2, R79.2, R80.2, R81.2; also elsewhere on the board
/A0: J8.20; also elsewhere on the board
/A1: J8.19; also elsewhere on the board
/A2: J8.18; also elsewhere on the board
/A3: R75.2; also elsewhere on the board
/CompactFlash/~CS1: J8.32, R77.1
/CompactFlash/~REG: J8.44, R78.1
/CompactFlash/~SPKR: D11.1 (K), J8.45
/CompactFlash/~STSCHG: J8.46, R79.1
/CompactFlash/~WE: J8.36, R80.1
/D0: J8.21; also elsewhere on the board
/D1: J8.22; also elsewhere on the board
/D2: J8.23; also elsewhere on the board
/D3: J8.2; also elsewhere on the board
/D4: J8.3; also elsewhere on the board
/D5: J8.4; also elsewhere on the board
/D6: J8.5; also elsewhere on the board
/D7: J8.6; also elsewhere on the board
CFnRES: J8.41; also elsewhere on the board
GND: C50.2, J8.1, J8.8, J8.9, J8.10, J8.11, J8.12, J8.14, J8.15, J8.16, J8.39, J8.50, J8.51, J8.52; also elsewhere on the board
unnamed: D11.2 (A), R81.1
unnamed: J8.17, R75.1
unnamed: J8.48, R76.1
nCF_CS0: J8.7; also elsewhere on the board
nR: J8.34; also elsewhere on the board
nW: J8.35; also elsewhere on the board

Notes on the sheet:
GREEN
Based on https://www.waveguide.se/?article=8-bit-compact-flash-interface & https://planck6502.com/fabrication/cf_board-schematic.pdf

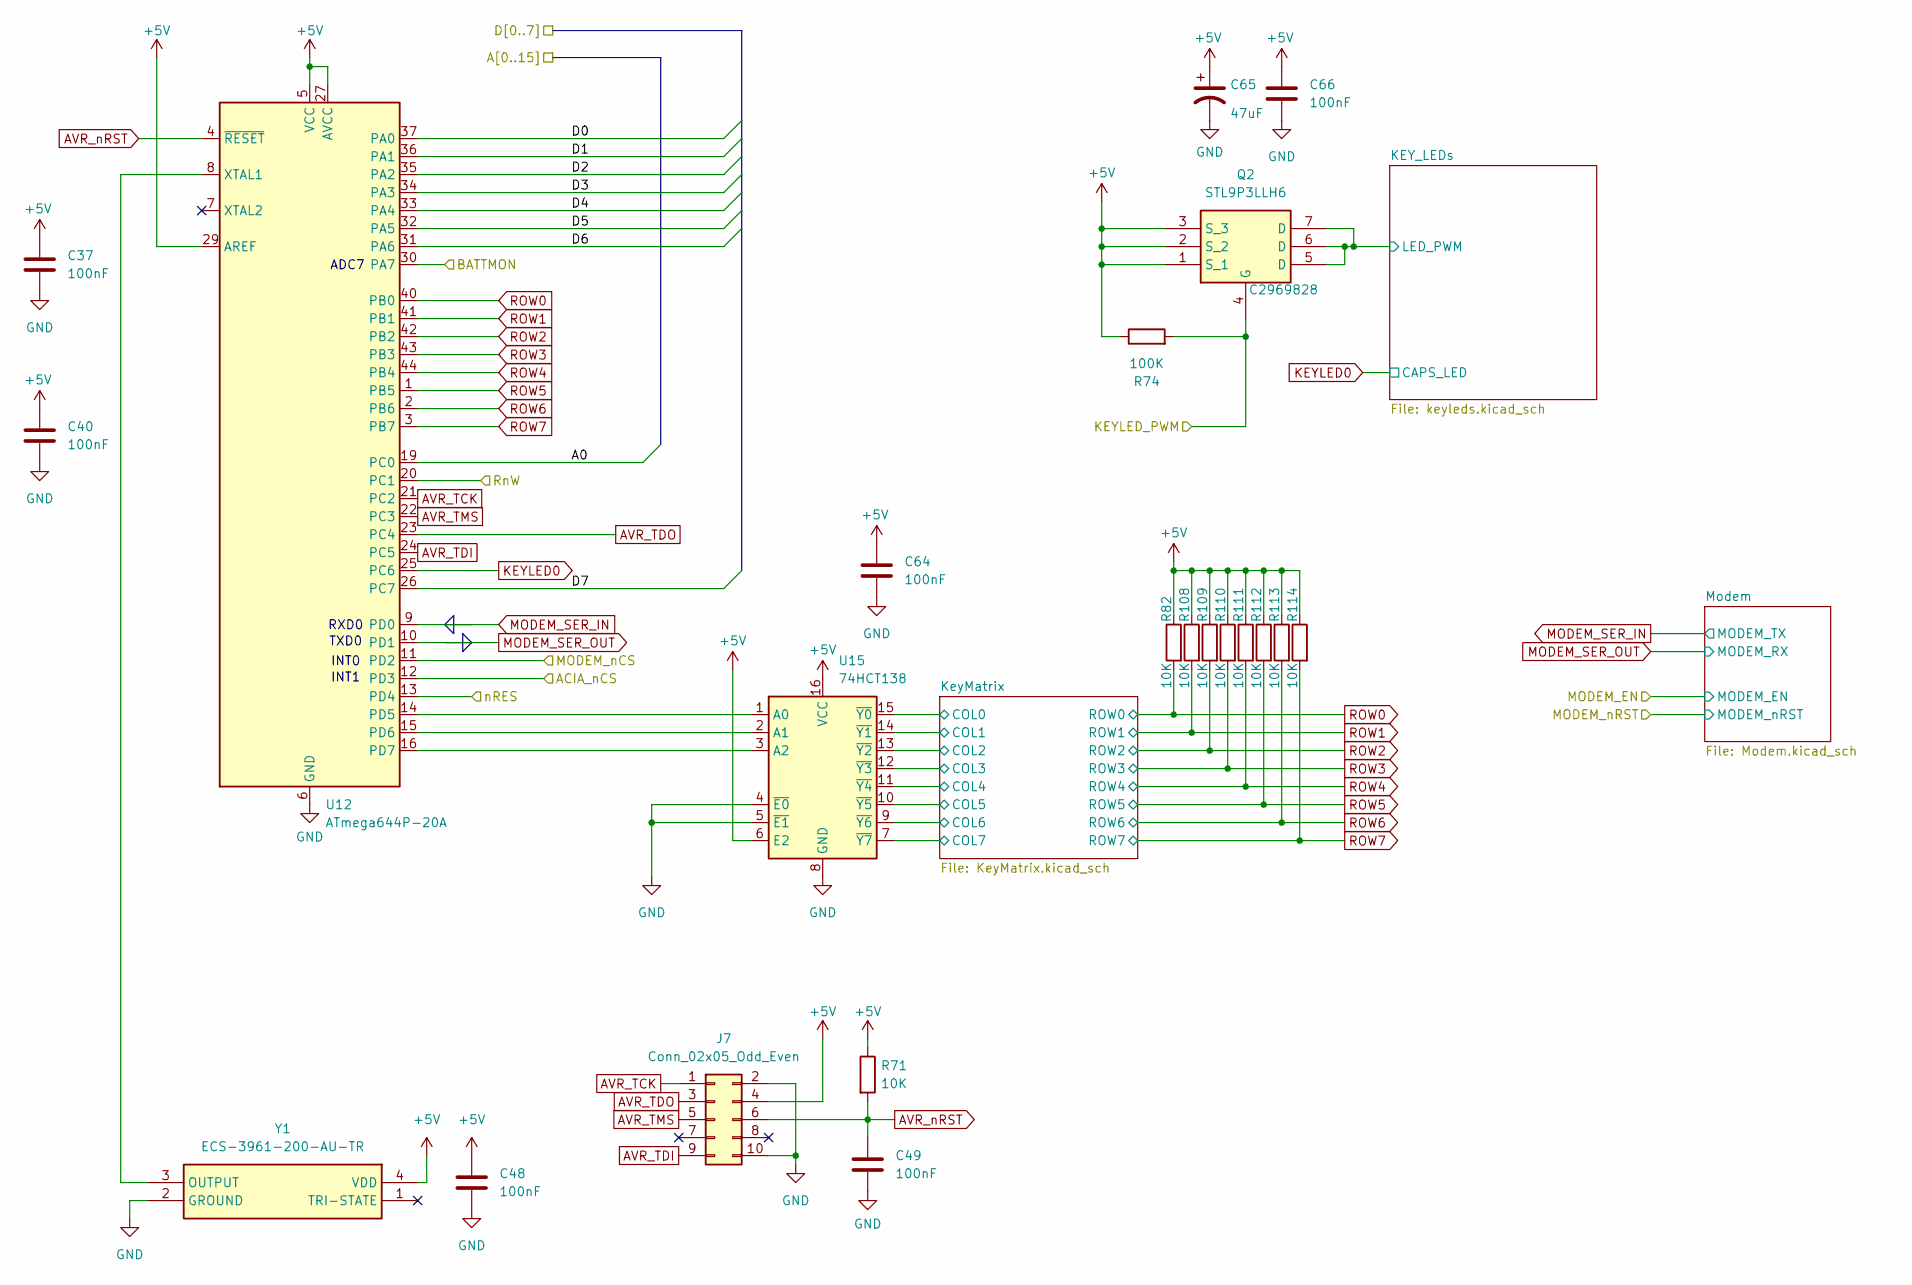
[picture p10: schematic KeyboardIF.kicad_sch]

Parts:
C37, C40, C49, C64, C66: 100nF; C_0805_2012Metric; LCSC C49678
C48: 100nF; C_0402_1005Metric; LCSC C113803
C65: 47uF; C_1206_3216Metric; LCSC C96123
J7: Conn_02x05_Odd_Even; PinHeader_2x05_P2.54mm_Horizontal; LCSC DNF
Q2: STL9P3LLH6; STL20N6F7; Manufacturer_Part_Number STL9P3LLH6; Mouser Part Number 511-STL9P3LLH6
R71, R82, R108, R109, R110, R111, R112, R113, R114: 10K; R_0603_1608Metric_Pad0.98x0.95mm_HandSolder; LCSC DNF
R74: 100K; R_0402_1005Metric; LCSC DNF
U12: ATmega644P-20A; TQFP-44_10x10mm_P0.8mm
U15: 74HCT138; SSOP-16_5.3x6.2mm_P0.65mm; LCSC C8115
Y1: ECS-3961-200-AU-TR; ECS3961200AUTR; Mouser Part Number 520-3961-200-AUT

Connections:
+5V: C37.1, C40.1, C48.1, C64.1, C65.1, C66.1, J7.4, Q2.1 (S_1), Q2.2 (S_2), Q2.3 (S_3), R71.1, R74.1, R82.1, R108.1, R109.1, R110.1, R111.1, R112.1, R113.1, R114.1, U12.5 (VCC), U12.17 (VCC), U12.27 (AVCC), U12.29 (AREF), U12.38 (VCC), U15.6 (E2), U15.16 (VCC), Y1.4 (VDD); also elsewhere on the board
/A0: U12.19 (PC0); also elsewhere on the board
/D0: U12.37 (PA0); also elsewhere on the board
/D1: U12.36 (PA1); also elsewhere on the board
/D2: U12.35 (PA2); also elsewhere on the board
/D3: U12.34 (PA3); also elsewhere on the board
/D4: U12.33 (PA4); also elsewhere on the board
/D5: U12.32 (PA5); also elsewhere on the board
/D6: U12.31 (PA6); also elsewhere on the board
/D7: U12.26 (PC7); also elsewhere on the board
/Keyboard IF/BATTMON: U12.30 (PA7); also elsewhere on the board
/Keyboard IF/KEY_LEDs/LED_PWM: Q2.5 (D), Q2.6 (D), Q2.7 (D); also elsewhere on the board
/Keyboard IF/KeyMatrix/COL0: U15.15 (~Y0); also elsewhere on the board
/Keyboard IF/KeyMatrix/COL1: U15.14 (~Y1); also elsewhere on the board
/Keyboard IF/KeyMatrix/COL2: U15.13 (~Y2); also elsewhere on the board
/Keyboard IF/KeyMatrix/COL3: U15.12 (~Y3); also elsewhere on the board
/Keyboard IF/KeyMatrix/COL4: U15.11 (~Y4); also elsewhere on the board
/Keyboard IF/KeyMatrix/COL5: U15.10 (~Y5); also elsewhere on the board
/Keyboard IF/KeyMatrix/COL6: U15.9 (~Y6); also elsewhere on the board
/Keyboard IF/KeyMatrix/COL7: U15.7 (~Y7); also elsewhere on the board
ACIA_nCS: U12.12 (PD3); also elsewhere on the board
AVR_TCK: J7.1, U12.21 (PC2)
AVR_TDI: J7.9, U12.24 (PC5)
AVR_TDO: J7.3, U12.23 (PC4)
AVR_TMS: J7.5, U12.22 (PC3)
AVR_nRST: C49.1, J7.6, R71.2, U12.4 (~RESET)
GND: C37.2, C40.2, C48.2, C49.2, C64.2, C65.2, C66.2, J7.2, J7.10, U12.6 (GND), U12.18 (GND), U12.28 (GND), U12.39 (GND), U15.4 (~E0), U15.5 (~E1), U15.8 (GND), Y1.2 (GROUND); also elsewhere on the board
KEYLED0: U12.25 (PC6); also elsewhere on the board
KEYLED_PWM: Q2.4 (G), R74.2; also elsewhere on the board
MODEM_SER_IN: U12.9 (PD0); also elsewhere on the board
MODEM_SER_OUT: U12.10 (PD1); also elsewhere on the board
MODEM_nCS: U12.11 (PD2); also elsewhere on the board
unnamed: U12.14 (PD5), U15.1 (A0)
unnamed: U12.15 (PD6), U15.2 (A1)
unnamed: U12.16 (PD7), U15.3 (A2)
unnamed: U12.8 (XTAL1), Y1.3 (OUTPUT)
ROW0: R82.2, U12.40 (PB0); also elsewhere on the board
ROW1: R108.2, U12.41 (PB1); also elsewhere on the board
ROW2: R109.2, U12.42 (PB2); also elsewhere on the board
ROW3: R110.2, U12.43 (PB3); also elsewhere on the board
ROW4: R111.2, U12.44 (PB4); also elsewhere on the board
ROW5: R112.2, U12.1 (PB5); also elsewhere on the board
ROW6: R113.2, U12.2 (PB6); also elsewhere on the board
ROW7: R114.2, U12.3 (PB7); also elsewhere on the board
RnW: U12.20 (PC1); also elsewhere on the board
nRES: U12.13 (PD4); also elsewhere on the board

Notes on the sheet:
INT0
INT1
ADC7
TXD0
RXD0

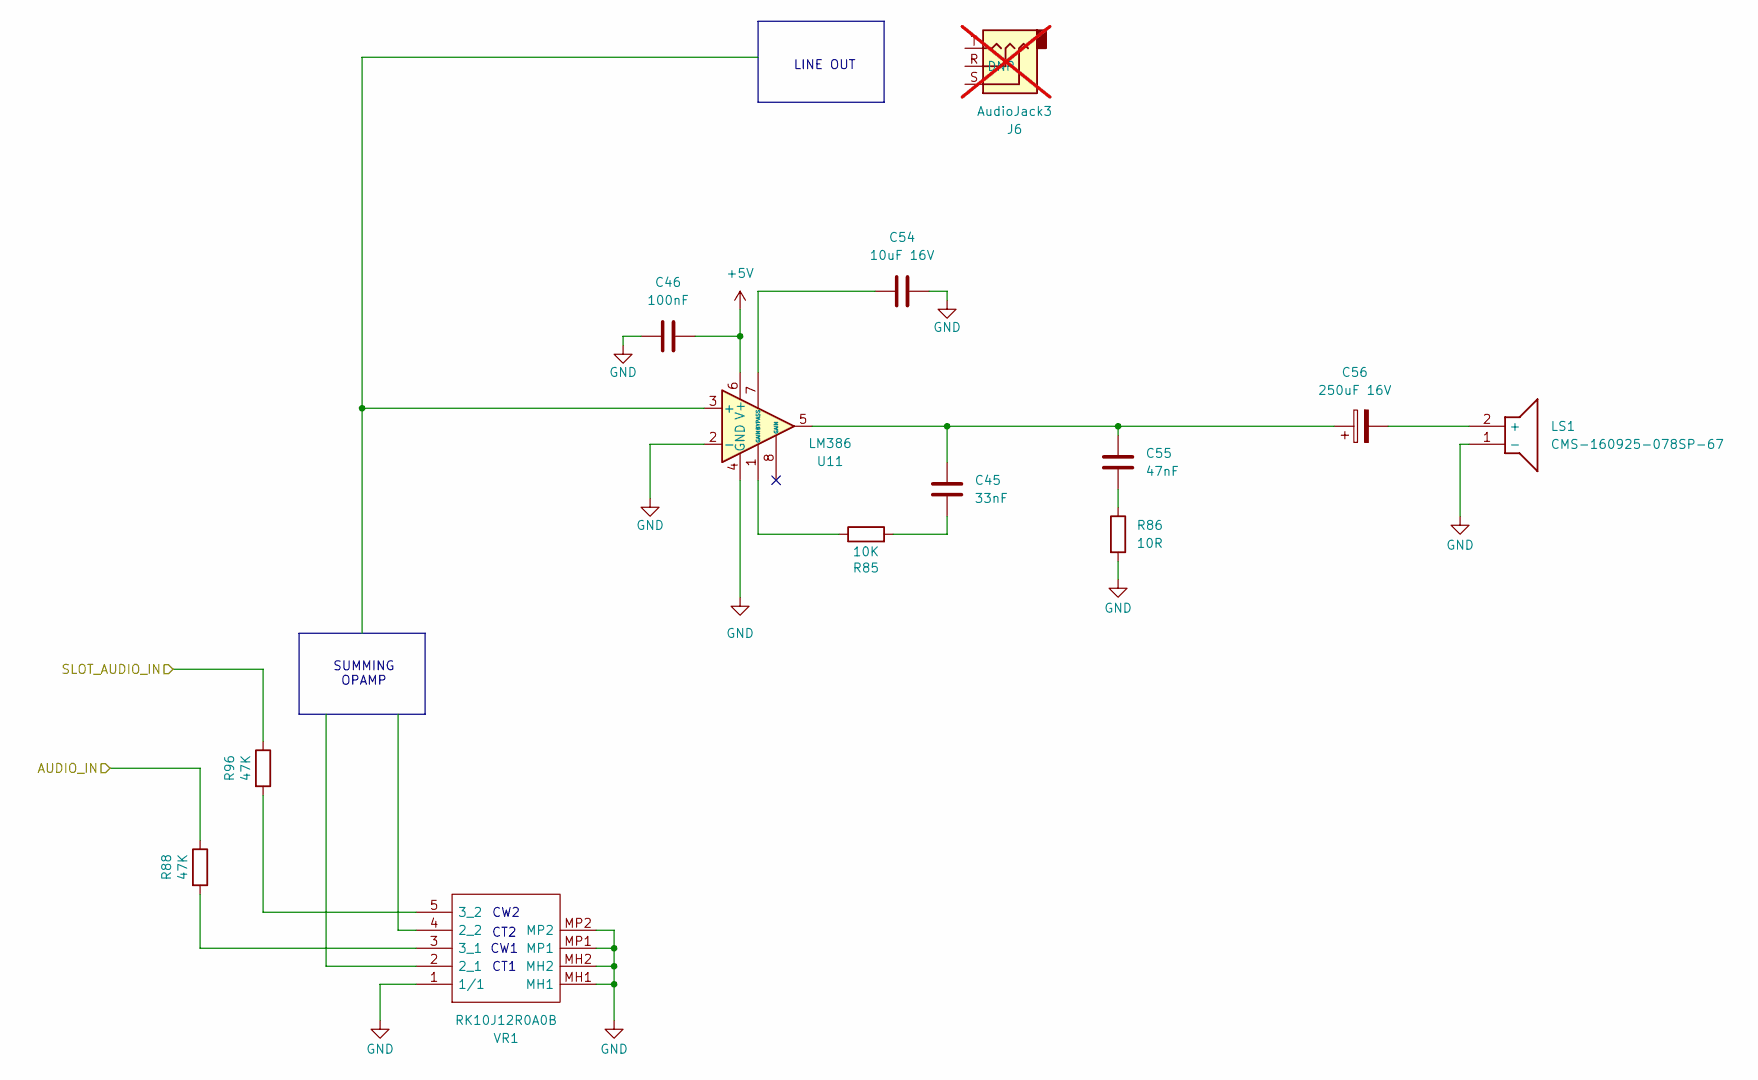
[picture p11: schematic Audio.kicad_sch]

Parts:
C45: 33nF; C_0603_1608Metric; LCSC C21117
C46: 100nF; C_0603_1608Metric; LCSC C113803
C54: 10uF 16V; C_0805_2012Metric; LCSC C15850
C55: 47nF; C_0603_1608Metric; LCSC C1622
C56: 250uF 16V; CP_Elec_10x12.5; Mouser Part Number 667-EEV-FK1V681Q
J6: AudioJack3; Jack_3.5mm_CUI_SJ-3524-SMT_Horizontal; LCSC DNP; not fitted
LS1: CMS-160925-078SP-67; CMS160925078SP67; Mouser Part Number 490-CMS160925078SP67
R85: 10K; R_0402_1005Metric; LCSC C25744
R86: 10R; R_0805_2012Metric; LCSC C844598
R88, R96: 47K; R_0402_1005Metric; LCSC DNF
U11: LM386; DIP-8_W7.62mm; Mouser Part Number 926-LM386N-3/NOPB
VR1: RK10J12R0A0B; Mouser Part Number 688-RK10J12R0A0B

Connections:
+5V: C46.2, U11.6 (V+); also elsewhere on the board
AUDIO: R88.1; also elsewhere on the board
GND: C46.1, C54.1, LS1.1 (-), R86.2, U11.2 (-), U11.4 (GND), VR1.1 (1/1), VR1.MH1, VR1.MH2, VR1.MP1, VR1.MP2; also elsewhere on the board
unnamed: C45.1, C55.1, C56.1, U11.5
unnamed: C45.2, R85.2
unnamed: C55.2, R86.1
unnamed: C56.2, LS1.2 (+)
unnamed: R85.1, U11.1 (GAIN)
unnamed: C54.2, U11.7 (BYPASS)
unnamed: R88.2, VR1.3 (3_1)
unnamed: R96.2, VR1.5 (3_2)
SLOT_AUDIO: R96.1; also elsewhere on the board

Notes on the sheet:
CT1
CT2
CW1
CW2
LINE OUT
SUMMING OPAMP
