TechPaula/LT6502b/Schematics/MainBoard/MainBoard.kicad_pcb

## KiCad design Schematics/MainBoard/MainBoard.kicad_pcb (continued)

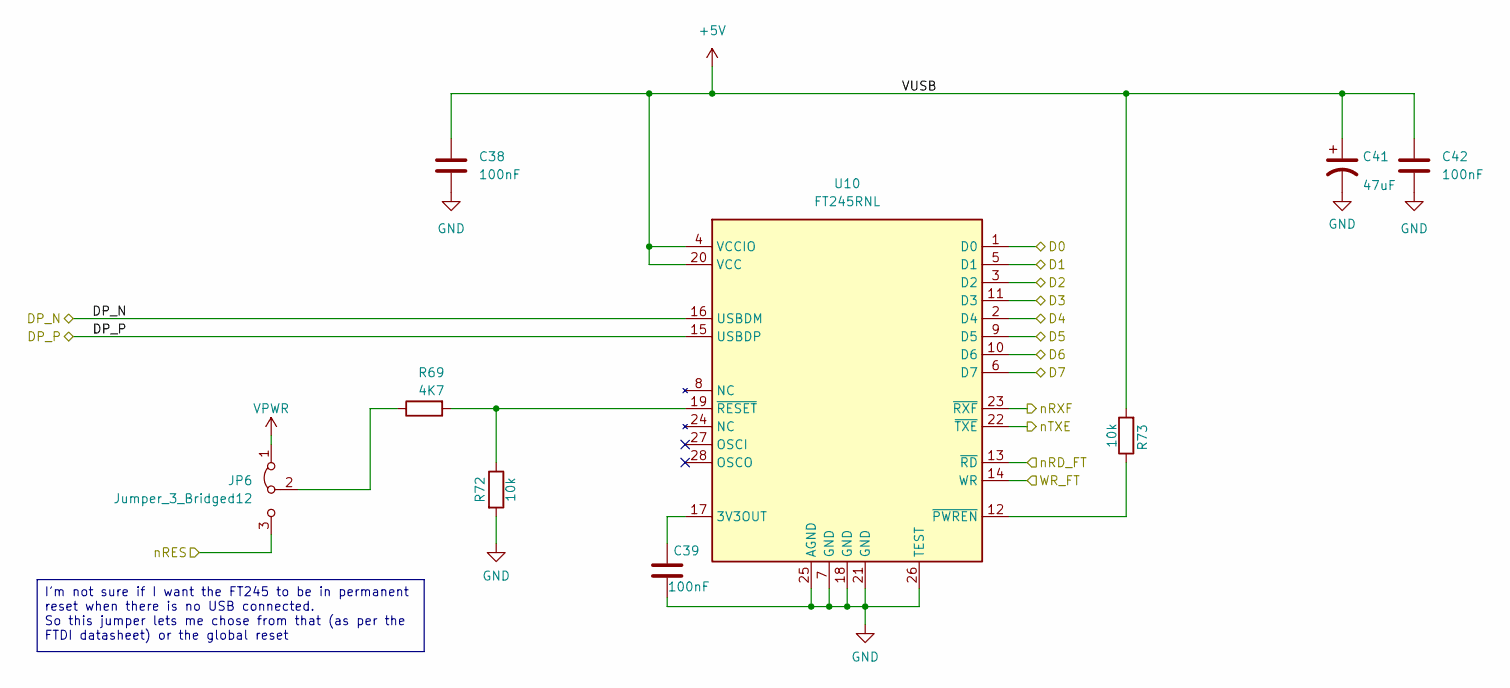
[picture p12: schematic 60FAKE50.kicad_sch]

Parts:
C38, C42: 100nF; C_0805_2012Metric; LCSC C49678
C39: 100nF; C_0603_1608Metric; LCSC C113803
C41: 47uF; C_1206_3216Metric; LCSC C22367835
JP6: Jumper_3_Bridged12; SolderJumper-3_P1.3mm_Bridged2Bar12_RoundedPad1.0x1.5mm
R69: 4K7; R_0402_1005Metric
R72, R73: 10k; R_0402_1005Metric; LCSC C25744
U10: FT245RNL; SSOP-28_5.3x10.2mm_P0.65mm; Mouser Part Number 895-FT245RNL-REEL; LCSC DNF

Connections:
+5V: C38.1, C41.1, C42.1, R73.2, U10.4 (VCCIO), U10.20 (VCC); also elsewhere on the board
/60FAKE50/nRES: JP6.3 (B)
/D0: U10.1 (D0); also elsewhere on the board
/D1: U10.5 (D1); also elsewhere on the board
/D2: U10.3 (D2); also elsewhere on the board
/D3: U10.11 (D3); also elsewhere on the board
/D4: U10.2 (D4); also elsewhere on the board
/D5: U10.9 (D5); also elsewhere on the board
/D6: U10.10 (D6); also elsewhere on the board
/D7: U10.6 (D7); also elsewhere on the board
DP_N: U10.16 (USBDM); also elsewhere on the board
DP_P: U10.15 (USBDP); also elsewhere on the board
GND: C38.2, C39.2, C41.2, C42.2, R72.2, U10.7 (GND), U10.18 (GND), U10.21 (GND), U10.25 (AGND), U10.26 (TEST); also elsewhere on the board
unnamed: JP6.2 (C), R69.1
unnamed: C39.1, U10.17 (3V3OUT)
unnamed: R73.1, U10.12 (~PWREN)
unnamed: R69.2, R72.1, U10.19 (~RESET)
VPWR: JP6.1 (A); also elsewhere on the board
WR_FT: U10.14 (WR); also elsewhere on the board
nRD_FT: U10.13 (~RD); also elsewhere on the board
nRXF: U10.23 (~RXF); also elsewhere on the board
nTXE: U10.22 (~TXE); also elsewhere on the board

Notes on the sheet:
I'm not sure if I want the FT245 to be in permanent reset when there is no USB connected. So this jumper lets me chose from that (as per the FTDI datasheet) or the global reset

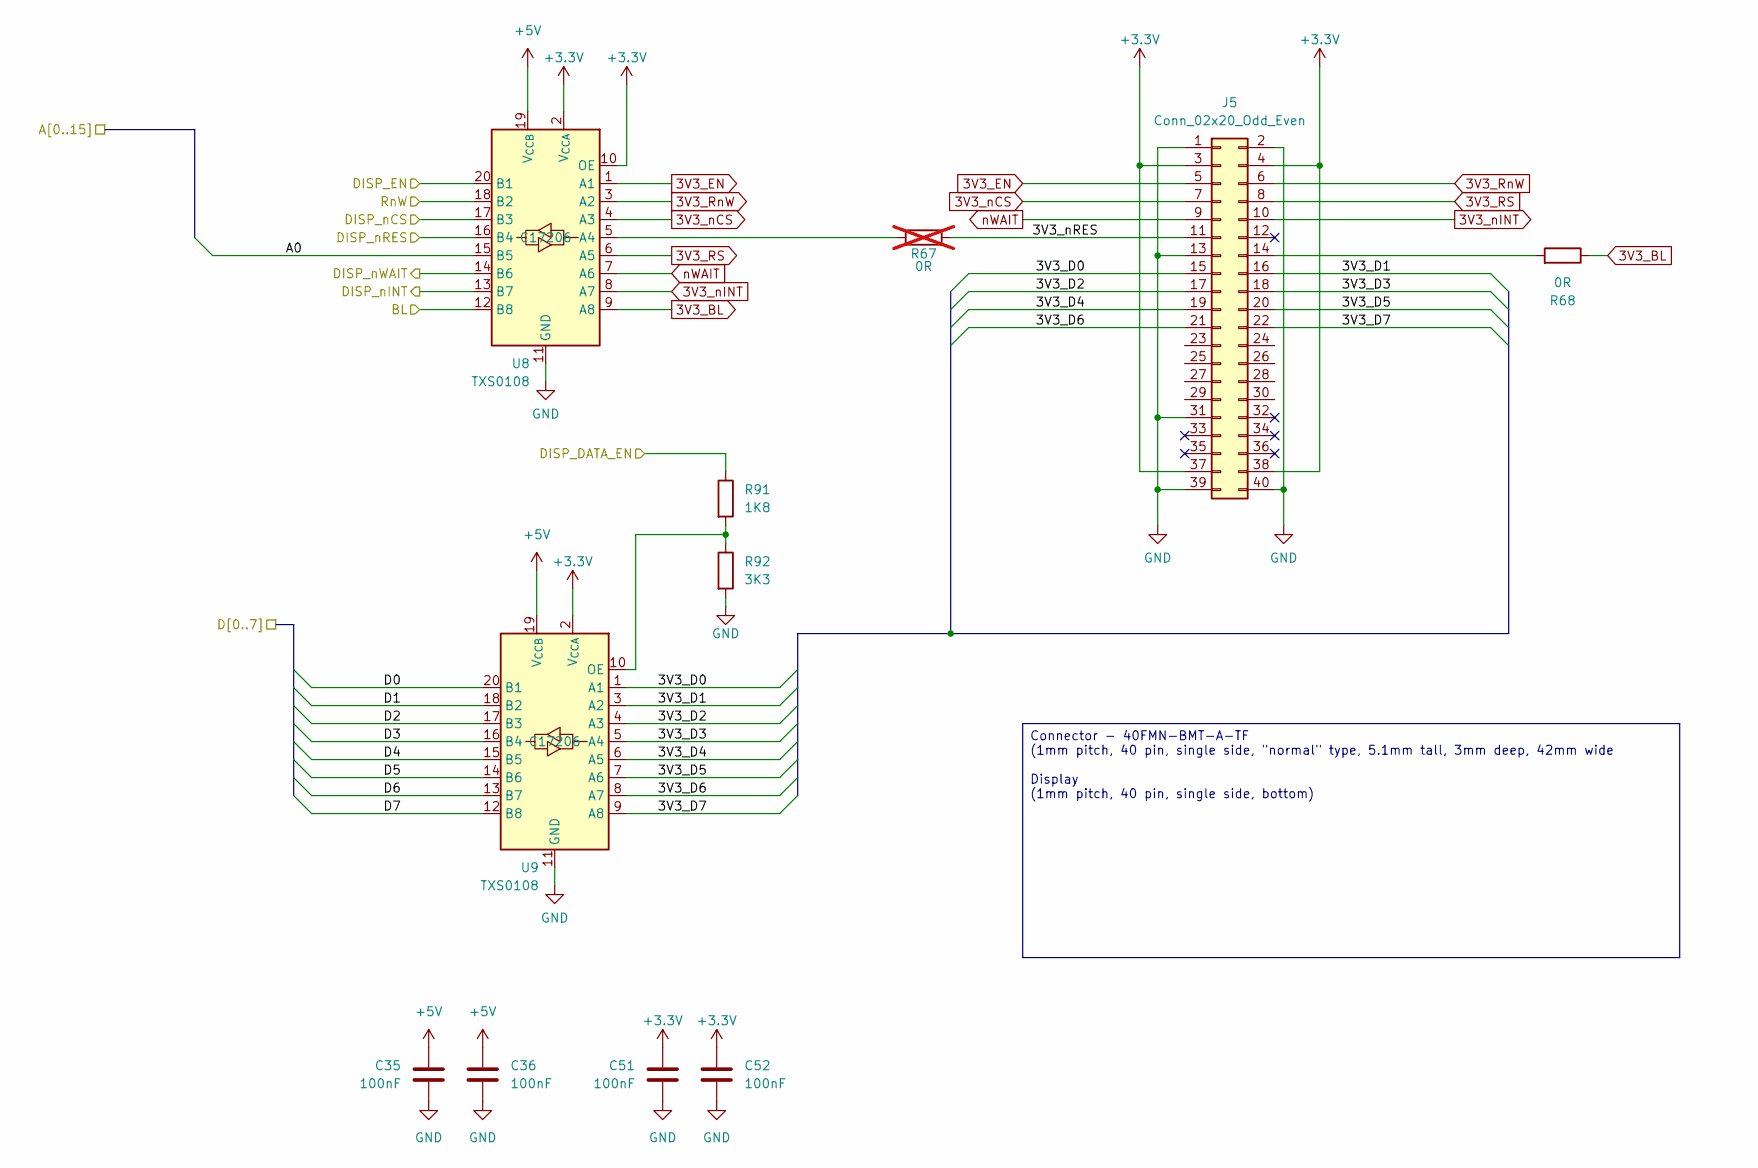
[picture p13: schematic DisplayConnector.kicad_sch]

Parts:
C35, C36, C51, C52: 100nF; C_0603_1608Metric; LCSC C113803
J5: Conn_02x20_Odd_Even; GCT_FFC3B07-40-T; LCSC DNF
R67: 0R; R_0402_1005Metric; LCSC DNF; not fitted
R68: 0R; R_0402_1005Metric; LCSC DNF
R91: 1K8; R_0603_1608Metric; LCSC C25890
R92: 3K3; R_0603_1608Metric; LCSC C25890
U8, U9: TXS0108; TSSOP-20_4.4x6.5mm_P0.65mm; Mouser Part Number 595-TXB0108PWR; LCSC C17206

Connections:
3V3_BL: R68.1, U8.9 (A8)
3V3_EN: J5.5, U8.1 (A1)
3V3_RS: J5.8, U8.6 (A5)
3V3_RnW: J5.6, U8.3 (A2)
3V3_nCS: J5.7, U8.4 (A3)
3V3_nINT: J5.10, U8.8 (A7)
+3.3V: C51.1, C52.1, J5.3, J5.4, J5.37, J5.38, U8.2 (V_{CCA}), U8.10 (OE), U9.2 (V_{CCA}); also elsewhere on the board
+5V: C35.1, C36.1, U8.19 (V_{CCB}), U9.19 (V_{CCB}); also elsewhere on the board
/A0: U8.15 (B5); also elsewhere on the board
/D0: U9.20 (B1); also elsewhere on the board
/D1: U9.18 (B2); also elsewhere on the board
/D2: U9.17 (B3); also elsewhere on the board
/D3: U9.16 (B4); also elsewhere on the board
/D4: U9.15 (B5); also elsewhere on the board
/D5: U9.14 (B6); also elsewhere on the board
/D6: U9.13 (B7); also elsewhere on the board
/D7: U9.12 (B8); also elsewhere on the board
/Display Connector/3V3_D0: J5.15, U9.1 (A1)
/Display Connector/3V3_D1: J5.16, U9.3 (A2)
/Display Connector/3V3_D2: J5.17, U9.4 (A3)
/Display Connector/3V3_D3: J5.18, U9.5 (A4)
/Display Connector/3V3_D4: J5.19, U9.6 (A5)
/Display Connector/3V3_D5: J5.20, U9.7 (A6)
/Display Connector/3V3_D6: J5.21, U9.8 (A7)
/Display Connector/3V3_D7: J5.22, U9.9 (A8)
/Display Connector/3V3_nRES: J5.11, R67.2
/Display Connector/BL: U8.12 (B8); also elsewhere on the board
/Display Connector/DISP_DATA_EN: R91.1; also elsewhere on the board
/Display Connector/DISP_EN: U8.20 (B1); also elsewhere on the board
/Display Connector/DISP_nCS: U8.17 (B3); also elsewhere on the board
/Display Connector/DISP_nINT: U8.13 (B7); also elsewhere on the board
/Display Connector/DISP_nRES: U8.16 (B4); also elsewhere on the board
/Display Connector/DISP_nWAIT: U8.14 (B6); also elsewhere on the board
GND: C35.2, C36.2, C51.2, C52.2, J5.1, J5.2, J5.13, J5.31, J5.39, J5.40, R92.2, U8.11 (GND), U9.11 (GND); also elsewhere on the board
unnamed: J5.14, R68.2
unnamed: R67.1, U8.5 (A4)
unnamed: R91.2, R92.1, U9.10 (OE)
RnW: U8.18 (B2); also elsewhere on the board
nWAIT: J5.9, U8.7 (A6)

Notes on the sheet:
Connector - 40FMN-BMT-A-TF (1mm pitch, 40 pin, single side, "normal" type, 5.1mm tall, 3mm deep, 42mm wide Display (1mm pitch, 40 pin, single side, bottom)

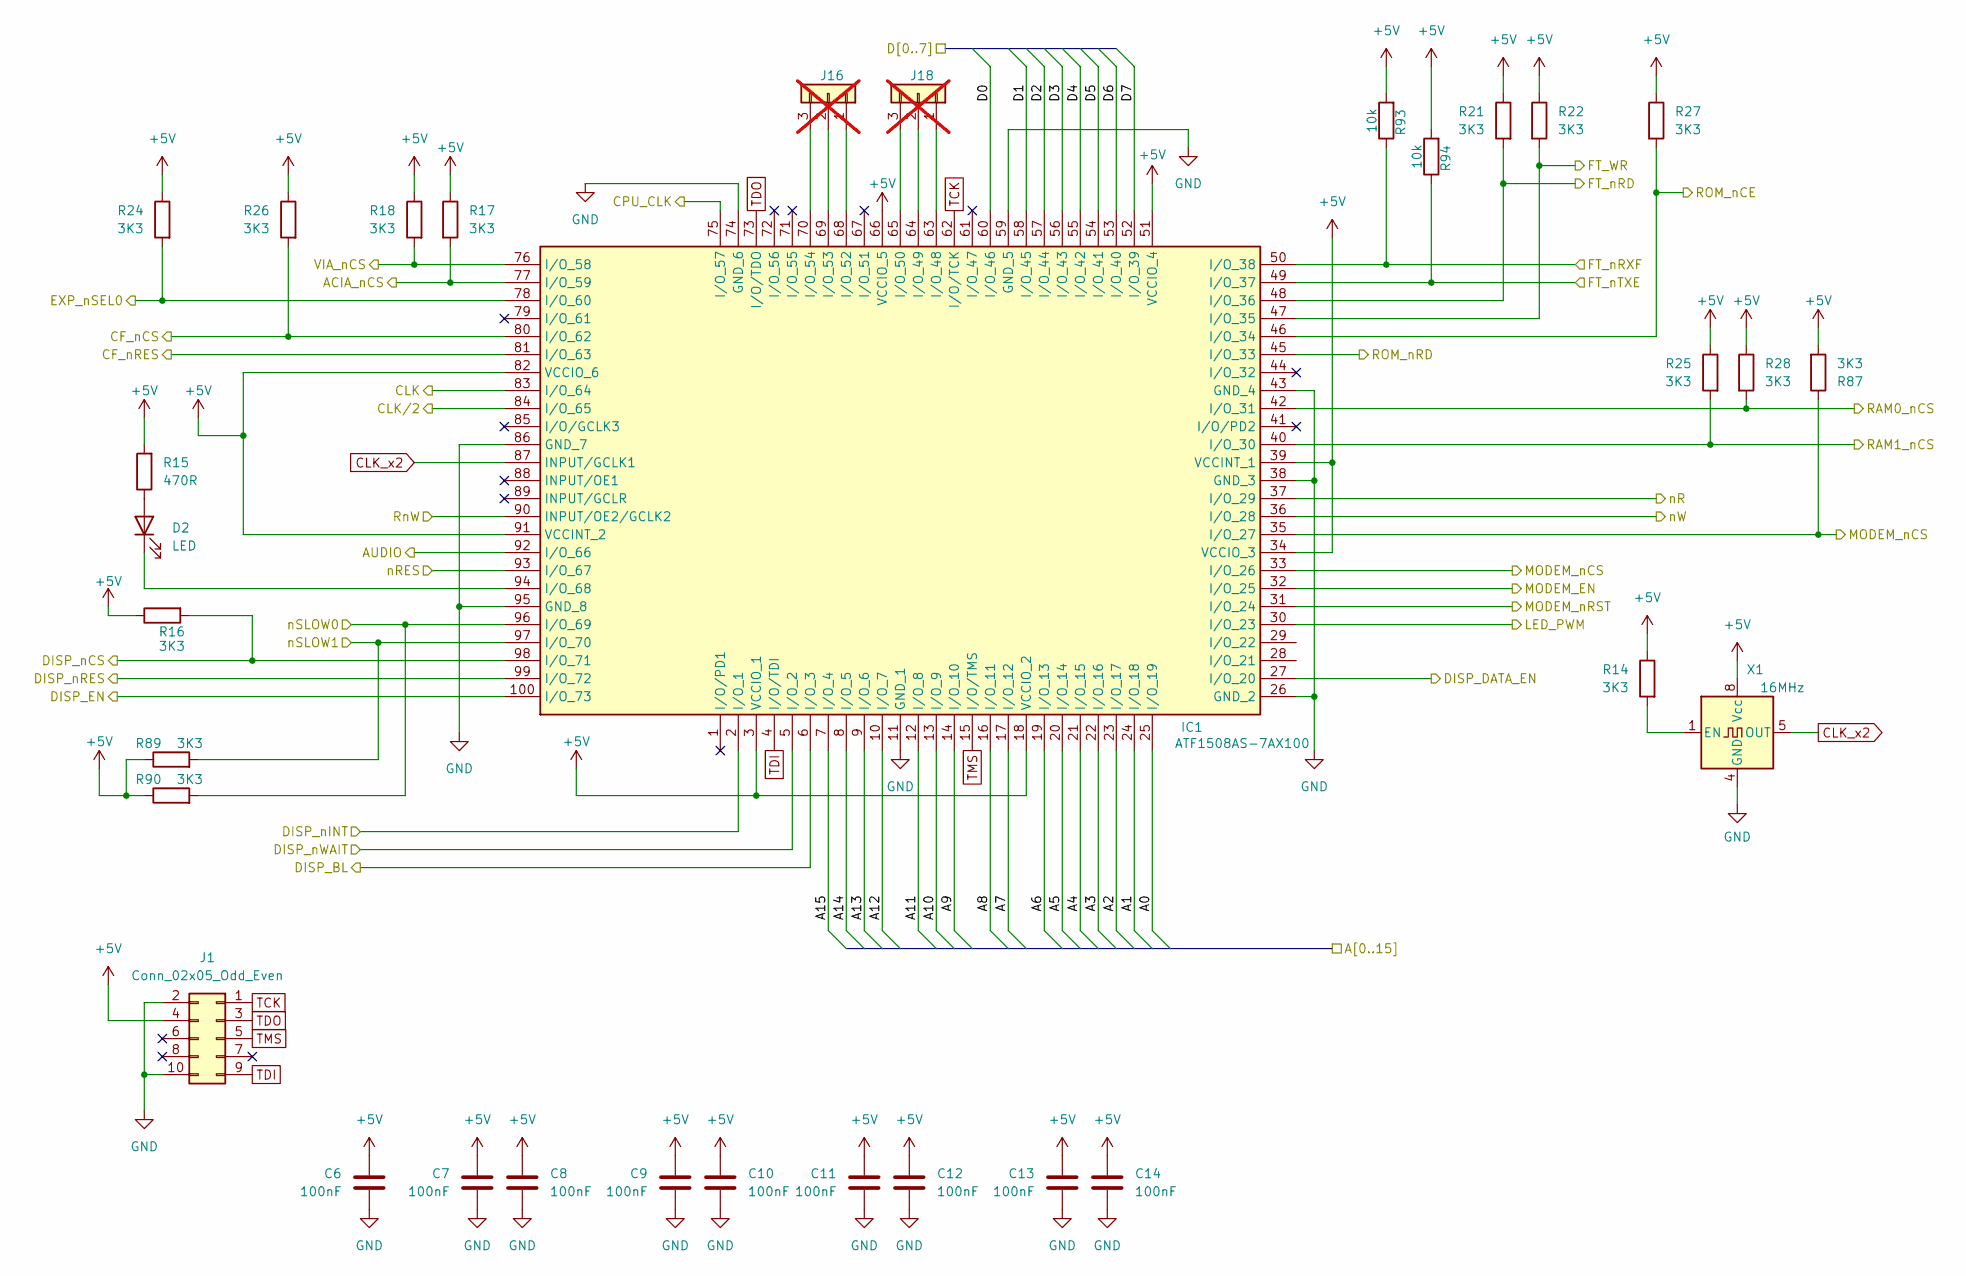
[picture p14: schematic Glue_Addr.kicad_sch]

Parts:
C6, C7, C8, C9, C11, C12, C13, C14: 100nF; C_0603_1608Metric; LCSC C113803
C10: 100nF; C_0402_1005Metric; LCSC C1581
D2: LED; LED_0603_1608Metric; LCSC DNF
IC1: ATF1508AS-7AX100; QFP50P1600X1600X120-100N; Mouser Part Number 556-AF1508AS7AX100
J1: Conn_02x05_Odd_Even; PinHeader_2x05_P2.54mm_Vertical; LCSC DNF
J16, J18: Conn_01x03; PinHeader_1x03_P1.00mm_Vertical_SMD_Pin1Left; LCSC DNF; not fitted
R14, R16, R17, R18, R21, R22, R24, R25, R26, R27, R28, R87, R89, R90: 3K3; R_0402_1005Metric; LCSC C25890
R15: 470R; R_0402_1005Metric; LCSC C25117
R93, R94: 10k; R_0402_1005Metric; LCSC C25744
X1: 16MHz; Oscillator_DIP-8; Mouser Part Number 520-2100AX-283.2; LCSC DNF

Connections:
+5V: C6.1, C7.1, C8.1, C9.1, C10.1, C11.1, C12.1, C13.1, C14.1, IC1.3 (VCCIO_1), IC1.18 (VCCIO_2), IC1.34 (VCCIO_3), IC1.39 (VCCINT_1), IC1.51 (VCCIO_4), IC1.66 (VCCIO_5), IC1.82 (VCCIO_6), IC1.91 (VCCINT_2), J1.4, R14.1, R15.2, R16.1, R17.1, R18.1, R21.1, R22.1, R24.1, R25.1, R26.1, R27.1, R28.1, R87.2, R89.1, R90.1, R93.2, R94.2, X1.8 (Vcc); also elsewhere on the board
/A0: IC1.25 (I/O_19); also elsewhere on the board
/A1: IC1.24 (I/O_18); also elsewhere on the board
/A2: IC1.23 (I/O_17); also elsewhere on the board
/A3: IC1.22 (I/O_16); also elsewhere on the board
/A4: IC1.21 (I/O_15); also elsewhere on the board
/A5: IC1.20 (I/O_14); also elsewhere on the board
/A6: IC1.19 (I/O_13); also elsewhere on the board
/A7: IC1.17 (I/O_12); also elsewhere on the board
/A8: IC1.16 (I/O_11); also elsewhere on the board
/A9: IC1.14 (I/O_10); also elsewhere on the board
/A10: IC1.13 (I/O_9); also elsewhere on the board
/A11: IC1.12 (I/O_8); also elsewhere on the board
/A12: IC1.10 (I/O_7); also elsewhere on the board
/A13: IC1.9 (I/O_6); also elsewhere on the board
/A14: IC1.8 (I/O_5); also elsewhere on the board
/A15: IC1.7 (I/O_4); also elsewhere on the board
/D0: IC1.60 (I/O_46); also elsewhere on the board
/D1: IC1.58 (I/O_45); also elsewhere on the board
/D2: IC1.57 (I/O_44); also elsewhere on the board
/D3: IC1.56 (I/O_43); also elsewhere on the board
/D4: IC1.55 (I/O_42); also elsewhere on the board
/D5: IC1.54 (I/O_41); also elsewhere on the board
/D6: IC1.53 (I/O_40); also elsewhere on the board
/D7: IC1.52 (I/O_39); also elsewhere on the board
/Display Connector/BL: IC1.6 (I/O_3); also elsewhere on the board
/Display Connector/DISP_DATA_EN: IC1.27 (I/O_20); also elsewhere on the board
/Display Connector/DISP_EN: IC1.100 (I/O_73); also elsewhere on the board
/Display Connector/DISP_nCS: IC1.98 (I/O_71), R16.2; also elsewhere on the board
/Display Connector/DISP_nINT: IC1.2 (I/O_1); also elsewhere on the board
/Display Connector/DISP_nRES: IC1.99 (I/O_72); also elsewhere on the board
/Display Connector/DISP_nWAIT: IC1.5 (I/O_2); also elsewhere on the board
ACIA_nCS: IC1.77 (I/O_59), R17.2; also elsewhere on the board
AUDIO: IC1.92 (I/O_66); also elsewhere on the board
CFnRES: IC1.80 (I/O_62), R26.2; also elsewhere on the board
CLK: IC1.83 (I/O_64); also elsewhere on the board
CLK_x2: IC1.87 (INPUT/GCLK1), X1.5 (OUT)
CLK/2: IC1.84 (I/O_65); also elsewhere on the board
CPU_CLK: IC1.75 (I/O_57); also elsewhere on the board
EXP_nSEL0: IC1.78 (I/O_60), R24.2; also elsewhere on the board
GND: C6.2, C7.2, C8.2, C9.2, C10.2, C11.2, C12.2, C13.2, C14.2, IC1.11 (GND_1), IC1.26 (GND_2), IC1.38 (GND_3), IC1.43 (GND_4), IC1.59 (GND_5), IC1.74 (GND_6), IC1.86 (GND_7), IC1.95 (GND_8), J1.2, J1.10, X1.4 (GND); also elsewhere on the board
KEYLED_PWM: IC1.30 (I/O_23); also elsewhere on the board
MODEM_EN: IC1.32 (I/O_25); also elsewhere on the board
MODEM_nCS: IC1.33 (I/O_26), IC1.35 (I/O_27), R87.1; also elsewhere on the board
MODEM_nRST: IC1.31 (I/O_24); also elsewhere on the board
unnamed: D2.2 (A), R15.1
unnamed: D2.1 (K), IC1.94 (I/O_68)
unnamed: IC1.63 (I/O_48), J18.1
unnamed: IC1.64 (I/O_49), J18.2
unnamed: IC1.65 (I/O_50), J18.3
unnamed: IC1.68 (I/O_52), J16.1
unnamed: IC1.69 (I/O_53), J16.2
unnamed: IC1.70 (I/O_54), J16.3
unnamed: R14.2, X1.1 (EN)
ROM_nCE: IC1.46 (I/O_34), R27.2; also elsewhere on the board
ROM_nR: IC1.45 (I/O_33); also elsewhere on the board
RnW: IC1.90 (INPUT/OE2/GCLK2); also elsewhere on the board
TCK: IC1.62 (I/O/TCK), J1.1
TDI: IC1.4 (I/O/TDI), J1.9
TDO: IC1.73 (I/O/TDO), J1.3
TMS: IC1.15 (I/O/TMS), J1.5
VIA_nCS: IC1.76 (I/O_58), R18.2; also elsewhere on the board
WR_FT: IC1.47 (I/O_35), R22.2; also elsewhere on the board
nCF_CS0: IC1.81 (I/O_63); also elsewhere on the board
nR: IC1.37 (I/O_29); also elsewhere on the board
nRAM0_CS: IC1.42 (I/O_31), R28.2; also elsewhere on the board
nRAM1_CS: IC1.40 (I/O_30), R25.2; also elsewhere on the board
nRD_FT: IC1.48 (I/O_36), R21.2; also elsewhere on the board
nRES: IC1.93 (I/O_67); also elsewhere on the board
nRXF: IC1.49 (I/O_37), R94.1; also elsewhere on the board
nSLOW0: IC1.96 (I/O_69), R90.2; also elsewhere on the board
nSLOW1: IC1.97 (I/O_70), R89.2; also elsewhere on the board
nTXE: IC1.50 (I/O_38), R93.1; also elsewhere on the board
nW: IC1.36 (I/O_28); also elsewhere on the board

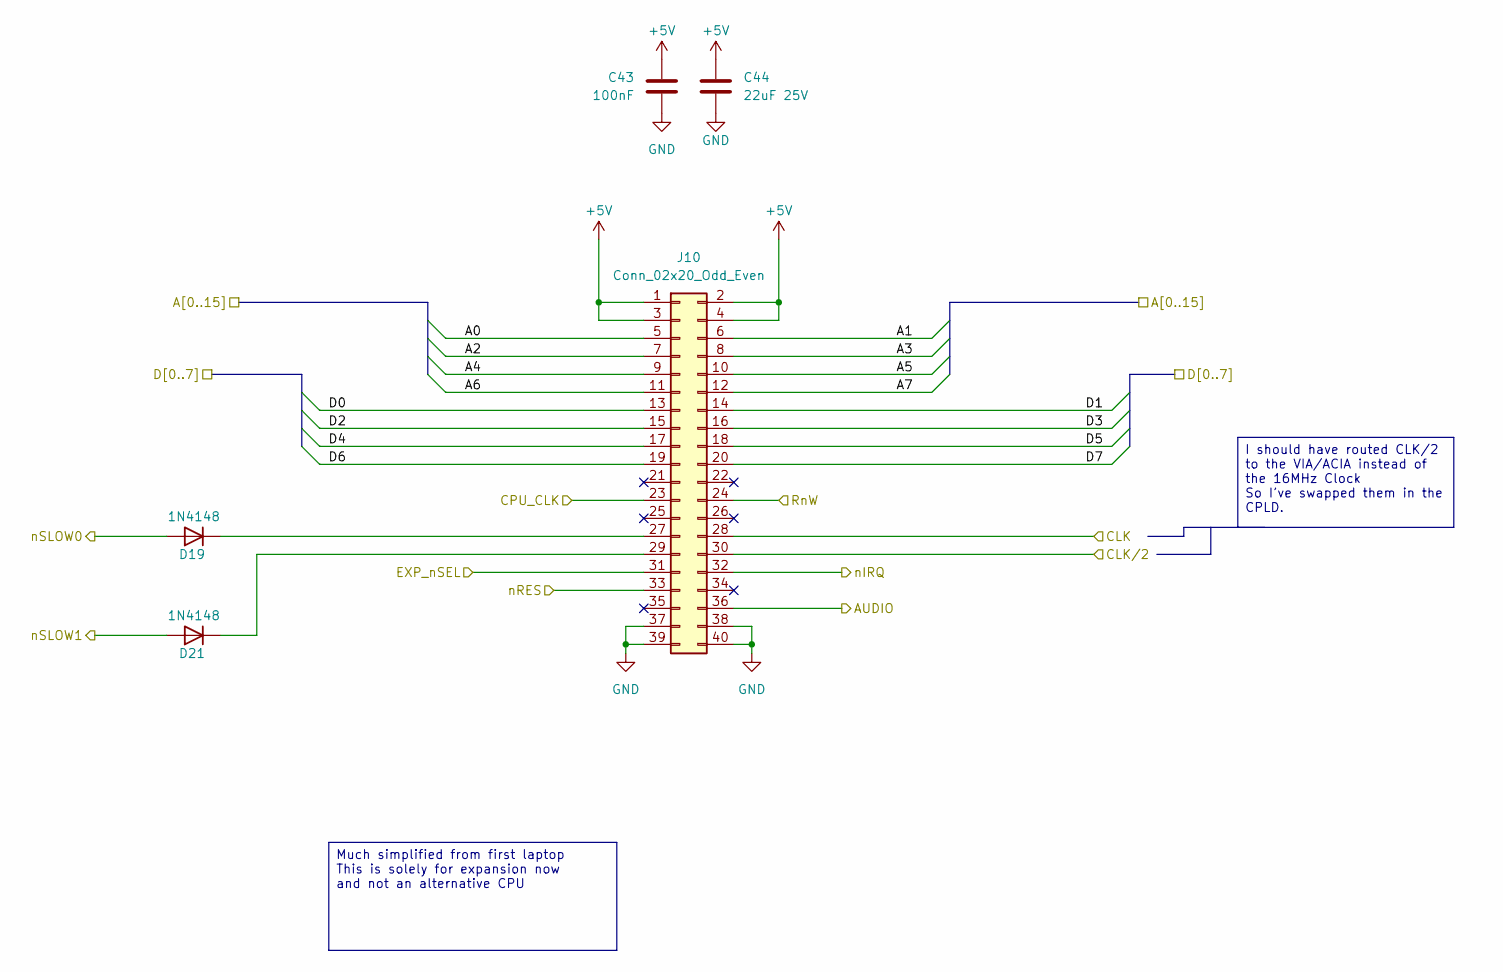
[picture p15: schematic Expansion.kicad_sch]

Parts:
C43: 100nF; C_0603_1608Metric; LCSC C113803
C44: 22uF 25V; C_0805_2012Metric; LCSC C45783
D19, D21: 1N4148; D_DO-35_SOD27_P7.62mm_Horizontal; LCSC DNF
J10: Conn_02x20_Odd_Even; PinHeader_2x20_P2.54mm_Horizontal

Connections:
+5V: C43.1, C44.1, J10.1, J10.2, J10.3, J10.4; also elsewhere on the board
/A0: J10.5; also elsewhere on the board
/A1: J10.6; also elsewhere on the board
/A2: J10.7; also elsewhere on the board
/A3: J10.8; also elsewhere on the board
/A4: J10.9; also elsewhere on the board
/A5: J10.10; also elsewhere on the board
/A6: J10.11; also elsewhere on the board
/A7: J10.12; also elsewhere on the board
/D0: J10.13; also elsewhere on the board
/D1: J10.14; also elsewhere on the board
/D2: J10.15; also elsewhere on the board
/D3: J10.16; also elsewhere on the board
/D4: J10.17; also elsewhere on the board
/D5: J10.18; also elsewhere on the board
/D6: J10.19; also elsewhere on the board
/D7: J10.20; also elsewhere on the board
CLK: J10.28; also elsewhere on the board
CLK/2: J10.30; also elsewhere on the board
CPU_CLK: J10.23; also elsewhere on the board
EXP_nSEL0: J10.31; also elsewhere on the board
GND: C43.2, C44.2, J10.37, J10.38, J10.39, J10.40; also elsewhere on the board
unnamed: D19.1 (K), J10.27
unnamed: D21.1 (K), J10.29
RnW: J10.24; also elsewhere on the board
SLOT_AUDIO: J10.36; also elsewhere on the board
nIRQ: J10.32; also elsewhere on the board
nRES: J10.33; also elsewhere on the board
nSLOW0: D19.2 (A); also elsewhere on the board
nSLOW1: D21.2 (A); also elsewhere on the board

Notes on the sheet:
I should have routed CLK/2 to the VIA/ACIA instead of the 16MHz Clock So I've swapped them in the CPLD.
Much simplified from first laptop This is solely for expansion now and not an alternative CPU

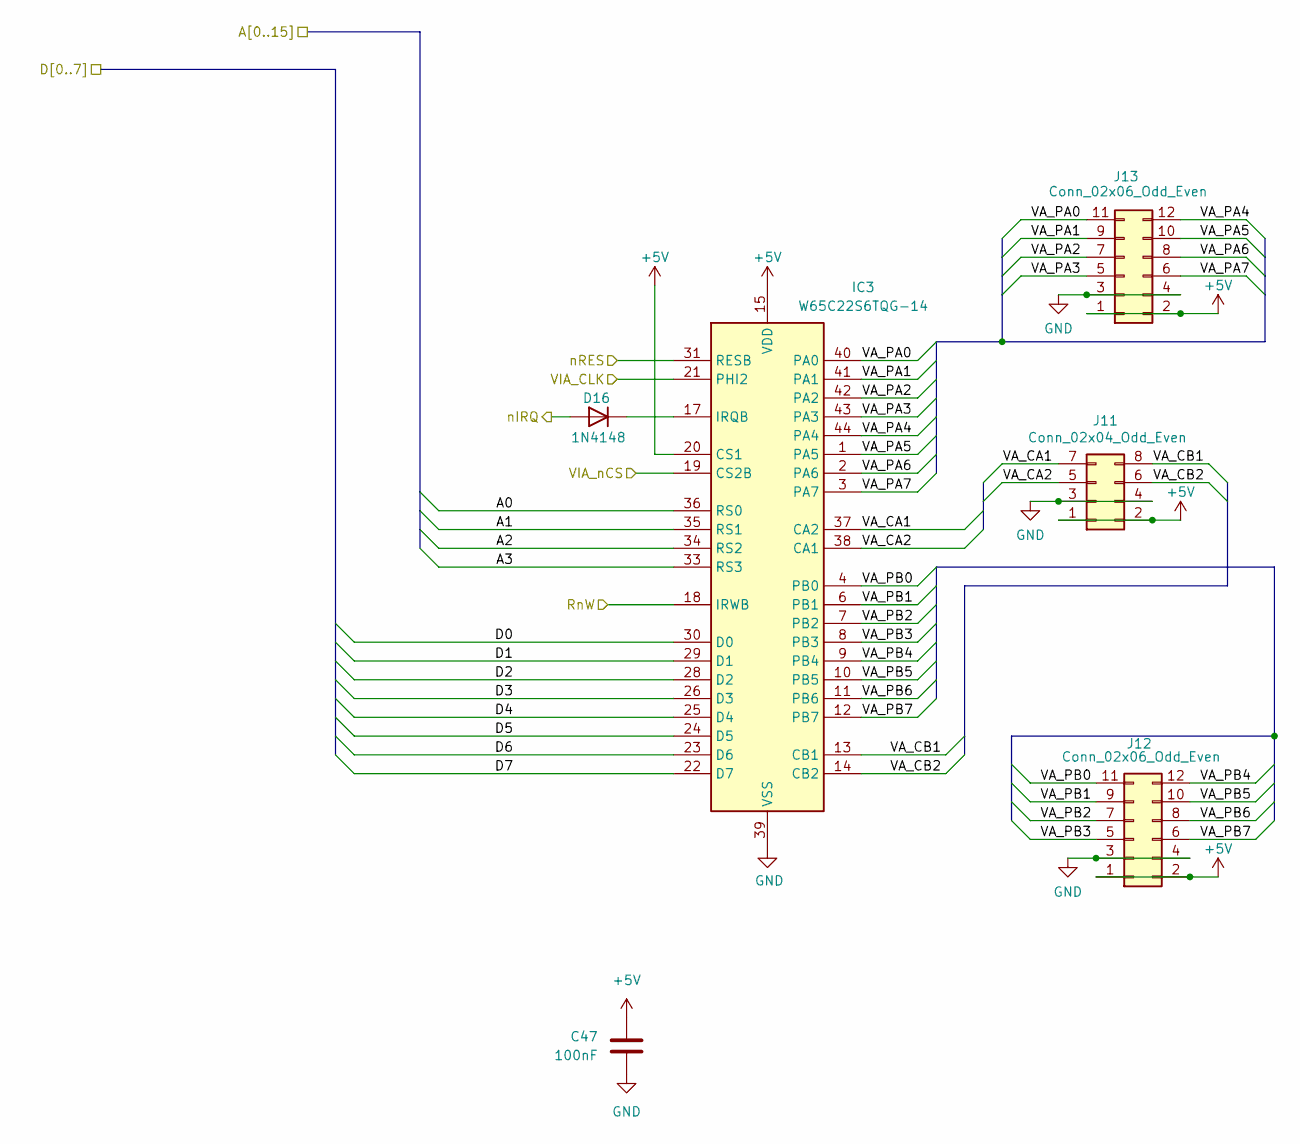
[picture p16: schematic VIA.kicad_sch]

Parts:
C47: 100nF; C_0603_1608Metric; LCSC C113803
D16: 1N4148; D_DO-35_SOD27_P7.62mm_Horizontal; LCSC DNF
IC3: W65C22S6TQG-14; QFP80P1320X1320X270-44N; Mouser Part Number 955-W65C22S6TQG-14
J11: Conn_02x04_Odd_Even; PinSocket_2x04_P2.54mm_Horizontal; LCSC DNF
J12, J13: Conn_02x06_Odd_Even; PinSocket_2x06_P2.54mm_Horizontal; LCSC DNF

Connections:
+5V: C47.1, IC3.15 (VDD), IC3.20 (CS1), J11.1, J11.2, J12.1, J12.2, J13.1, J13.2; also elsewhere on the board
/A0: IC3.36 (RS0); also elsewhere on the board
/A1: IC3.35 (RS1); also elsewhere on the board
/A2: IC3.34 (RS2); also elsewhere on the board
/A3: IC3.33 (RS3); also elsewhere on the board
/D0: IC3.30 (D0); also elsewhere on the board
/D1: IC3.29 (D1); also elsewhere on the board
/D2: IC3.28 (D2); also elsewhere on the board
/D3: IC3.26 (D3); also elsewhere on the board
/D4: IC3.25 (D4); also elsewhere on the board
/D5: IC3.24 (D5); also elsewhere on the board
/D6: IC3.23 (D6); also elsewhere on the board
/D7: IC3.22 (D7); also elsewhere on the board
/VIA/VA_CA1: IC3.37 (CA2), J11.7
/VIA/VA_CA2: IC3.38 (CA1), J11.5
/VIA/VA_CB1: IC3.13 (CB1), J11.8
/VIA/VA_CB2: IC3.14 (CB2), J11.6
/VIA/VA_PA0: IC3.40 (PA0), J13.11
/VIA/VA_PA1: IC3.41 (PA1), J13.9
/VIA/VA_PA2: IC3.42 (PA2), J13.7
/VIA/VA_PA3: IC3.43 (PA3), J13.5
/VIA/VA_PA4: IC3.44 (PA4), J13.12
/VIA/VA_PA5: IC3.1 (PA5), J13.10
/VIA/VA_PA6: IC3.2 (PA6), J13.8
/VIA/VA_PA7: IC3.3 (PA7), J13.6
/VIA/VA_PB0: IC3.4 (PB0), J12.11
/VIA/VA_PB1: IC3.6 (PB1), J12.9
/VIA/VA_PB2: IC3.7 (PB2), J12.7
/VIA/VA_PB3: IC3.8 (PB3), J12.5
/VIA/VA_PB4: IC3.9 (PB4), J12.12
/VIA/VA_PB5: IC3.10 (PB5), J12.10
/VIA/VA_PB6: IC3.11 (PB6), J12.8
/VIA/VA_PB7: IC3.12 (PB7), J12.6
CLK: IC3.21 (PHI2); also elsewhere on the board
GND: C47.2, IC3.39 (VSS), J11.3, J11.4, J12.3, J12.4, J13.3, J13.4; also elsewhere on the board
unnamed: D16.1 (K), IC3.17 (IRQB)
RnW: IC3.18 (IRWB); also elsewhere on the board
VIA_nCS: IC3.19 (CS2B); also elsewhere on the board
nIRQ: D16.2 (A); also elsewhere on the board
nRES: IC3.31 (RESB); also elsewhere on the board

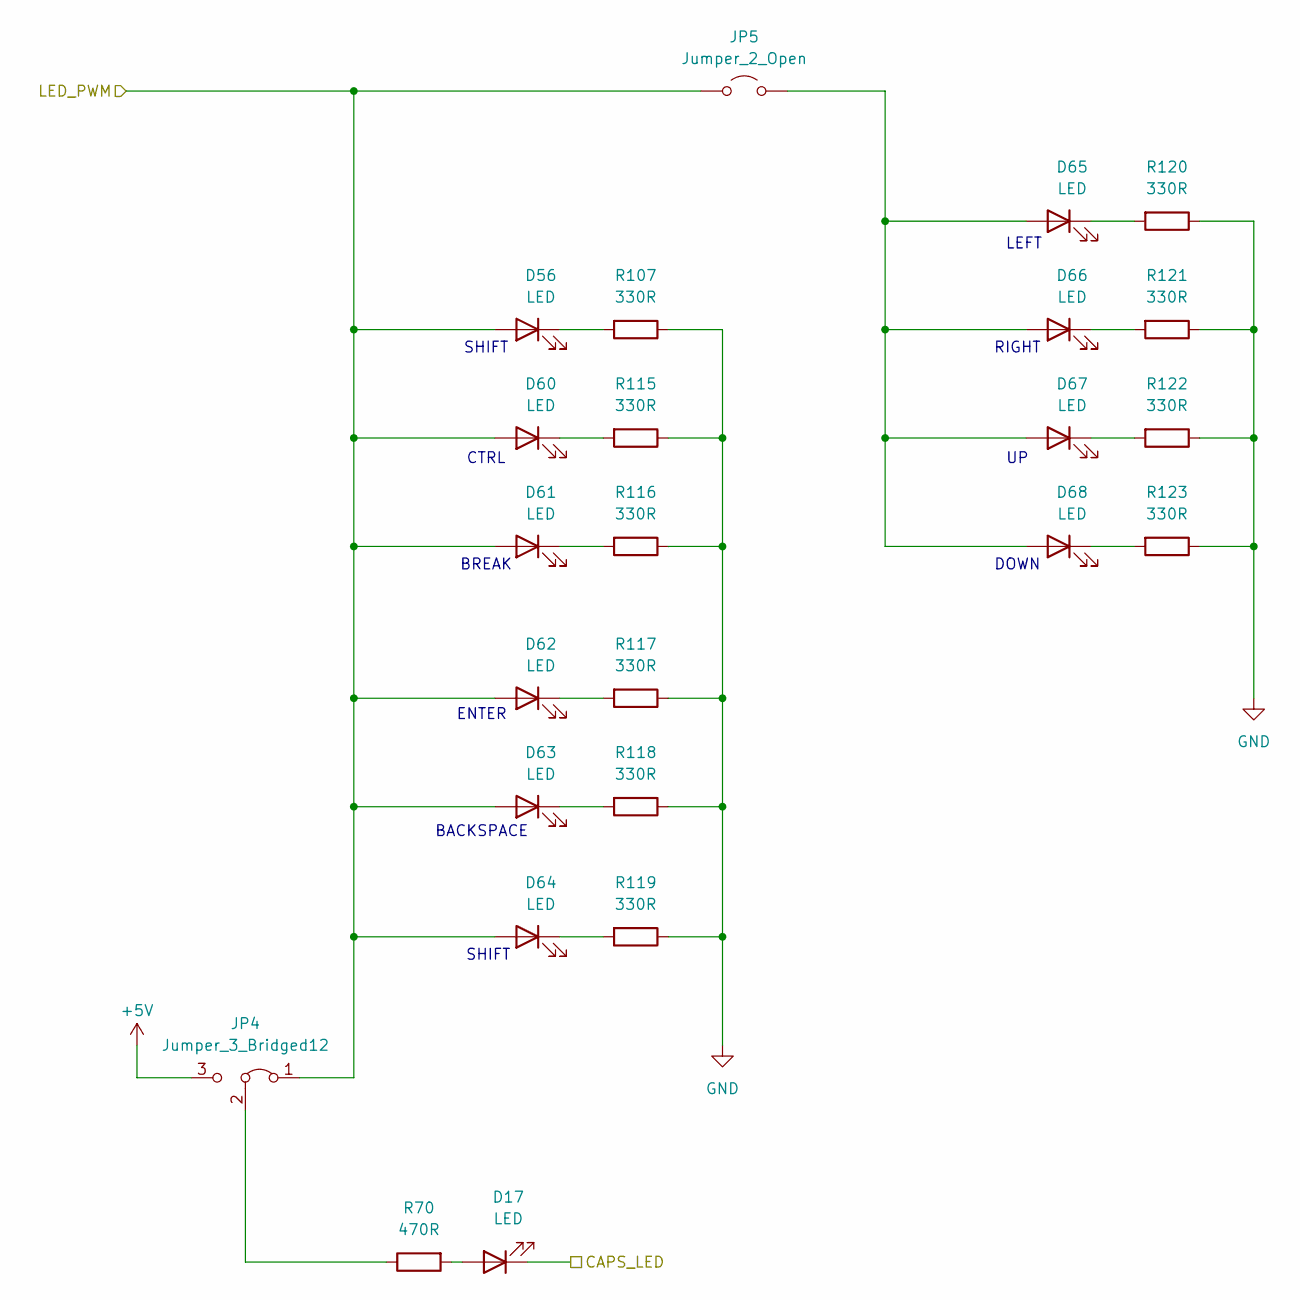
[picture p17: schematic keyleds.kicad_sch]

Parts:
D17: LED; LED_D5.0mm; LCSC DNF
D56, D60, D61, D62, D63, D64, D65, D66, D67, D68: LED; LED_0603_1608Metric; LCSC C3030991
JP4: Jumper_3_Bridged12; SolderJumper-3_P1.3mm_Bridged2Bar12_RoundedPad1.0x1.5mm
JP5: Jumper_2_Open; SolderJumper-2_P1.3mm_Open_TrianglePad1.0x1.5mm; LCSC DNF
R70: 470R; R_0603_1608Metric_Pad0.98x0.95mm_HandSolder; LCSC DNF
R107, R115, R116, R117, R118, R119, R120, R121, R122, R123: 330R; R_0603_1608Metric_Pad0.98x0.95mm_HandSolder; LCSC DNF

Connections:
+5V: JP4.3 (B); also elsewhere on the board
/Keyboard IF/KEY_LEDs/LED_PWM: D56.2 (A), D60.2 (A), D61.2 (A), D62.2 (A), D63.2 (A), D64.2 (A), JP4.1 (A), JP5.1 (A); also elsewhere on the board
GND: R107.1, R115.1, R116.1, R117.1, R118.1, R119.1, R120.1, R121.1, R122.1, R123.1; also elsewhere on the board
KEYLED0: D17.1 (K); also elsewhere on the board
unnamed: D17.2 (A), R70.2
unnamed: D56.1 (K), R107.2
unnamed: D60.1 (K), R115.2
unnamed: D61.1 (K), R116.2
unnamed: D62.1 (K), R117.2
unnamed: D63.1 (K), R118.2
unnamed: D64.1 (K), R119.2
unnamed: D65.2 (A), D66.2 (A), D67.2 (A), D68.2 (A), JP5.2 (B)
unnamed: D65.1 (K), R120.2
unnamed: D66.1 (K), R121.2
unnamed: D67.1 (K), R122.2
unnamed: D68.1 (K), R123.2
unnamed: JP4.2 (C), R70.1

Notes on the sheet:
LEFT
ENTER
SHIFT
RIGHT
BREAK
BACKSPACE
CTRL
DOWN

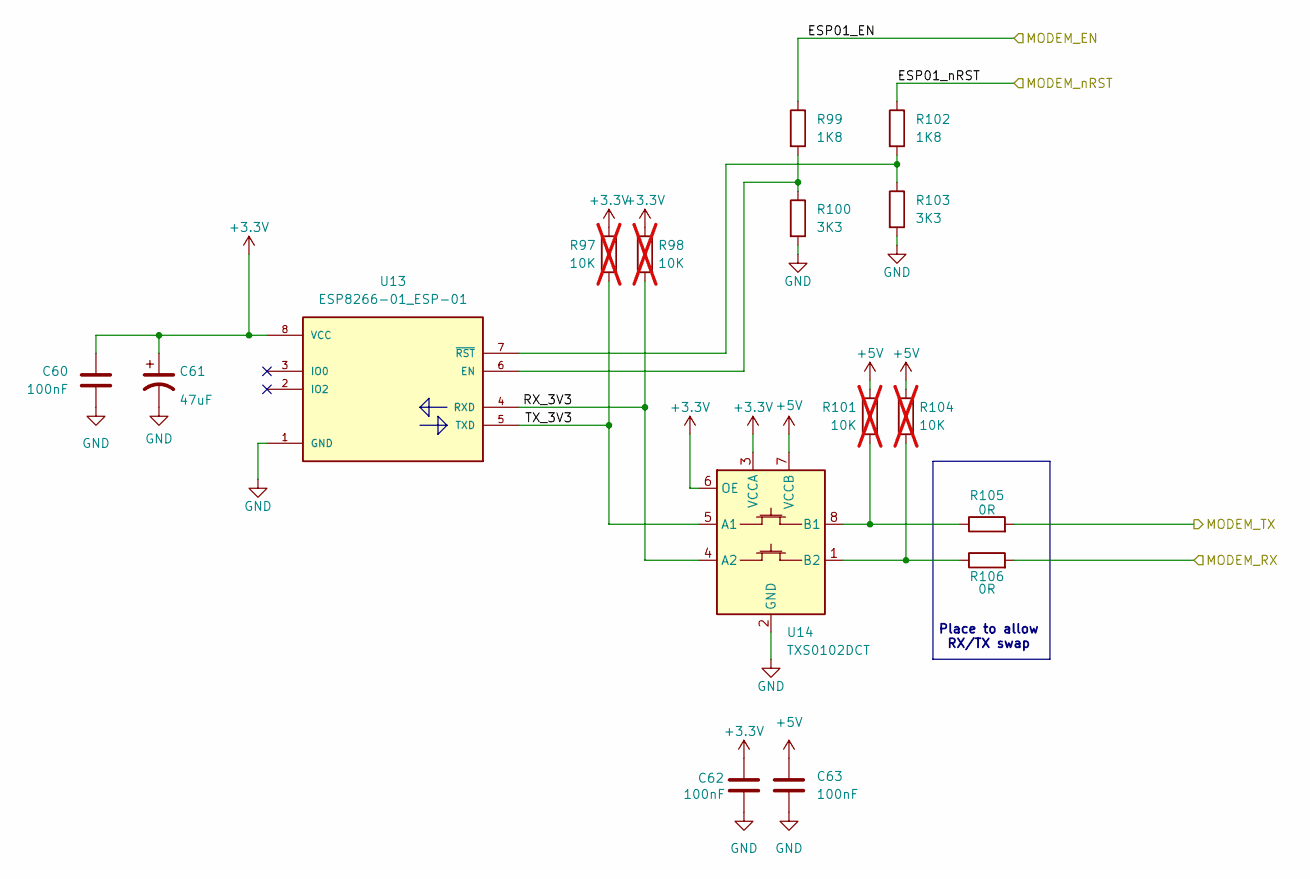
[picture p18: schematic Modem.kicad_sch]

Parts:
C60, C62, C63: 100nF; C_0402_1005Metric; LCSC C113803
C61: 47uF; C_1206_3216Metric; LCSC C96123
R97, R98, R101, R104: 10K; R_0402_1005Metric; LCSC DNF; not fitted
R99, R102: 1K8; R_0603_1608Metric; LCSC C25890
R100, R103: 3K3; R_0603_1608Metric; LCSC C25890
R105, R106: 0R; R_0603_1608Metric
U13: ESP8266-01_ESP-01; XCVR_ESP8266-01_ESP-01; PARTREV V1.2
U14: TXS0102DCT; SSOP-8_2.95x2.8mm_P0.65mm

Connections:
+3.3V: C60.1, C61.1, C62.1, R97.1, R98.1, U13.8 (VCC), U14.3 (VCCA), U14.6 (OE); also elsewhere on the board
+5V: C63.1, R101.1, R104.1, U14.7 (VCCB); also elsewhere on the board
/Keyboard IF/Modem/RX_3V3: R98.2, U13.4 (RXD), U14.4 (A2)
/Keyboard IF/Modem/TX_3V3: R97.2, U13.5 (TXD), U14.5 (A1)
GND: C60.2, C61.2, C62.2, C63.2, R100.2, R103.2, U13.1 (GND), U14.2 (GND); also elsewhere on the board
MODEM_EN: R99.1; also elsewhere on the board
MODEM_SER_IN: R105.2; also elsewhere on the board
MODEM_SER_OUT: R106.2; also elsewhere on the board
MODEM_nRST: R102.1; also elsewhere on the board
unnamed: R99.2, R100.1, U13.6 (EN)
unnamed: R102.2, R103.1, U13.7 (~RST)
unnamed: R101.2, R105.1, U14.8 (B1)
unnamed: R104.2, R106.1, U14.1 (B2)

Notes on the sheet:
Place to allow RX/TX swap
