TechPaula/LT6502b/Schematics/MainBoard/MainBoard.kicad_pcb

## KiCad design Schematics/MainBoard/MainBoard.kicad_pcb (continued)

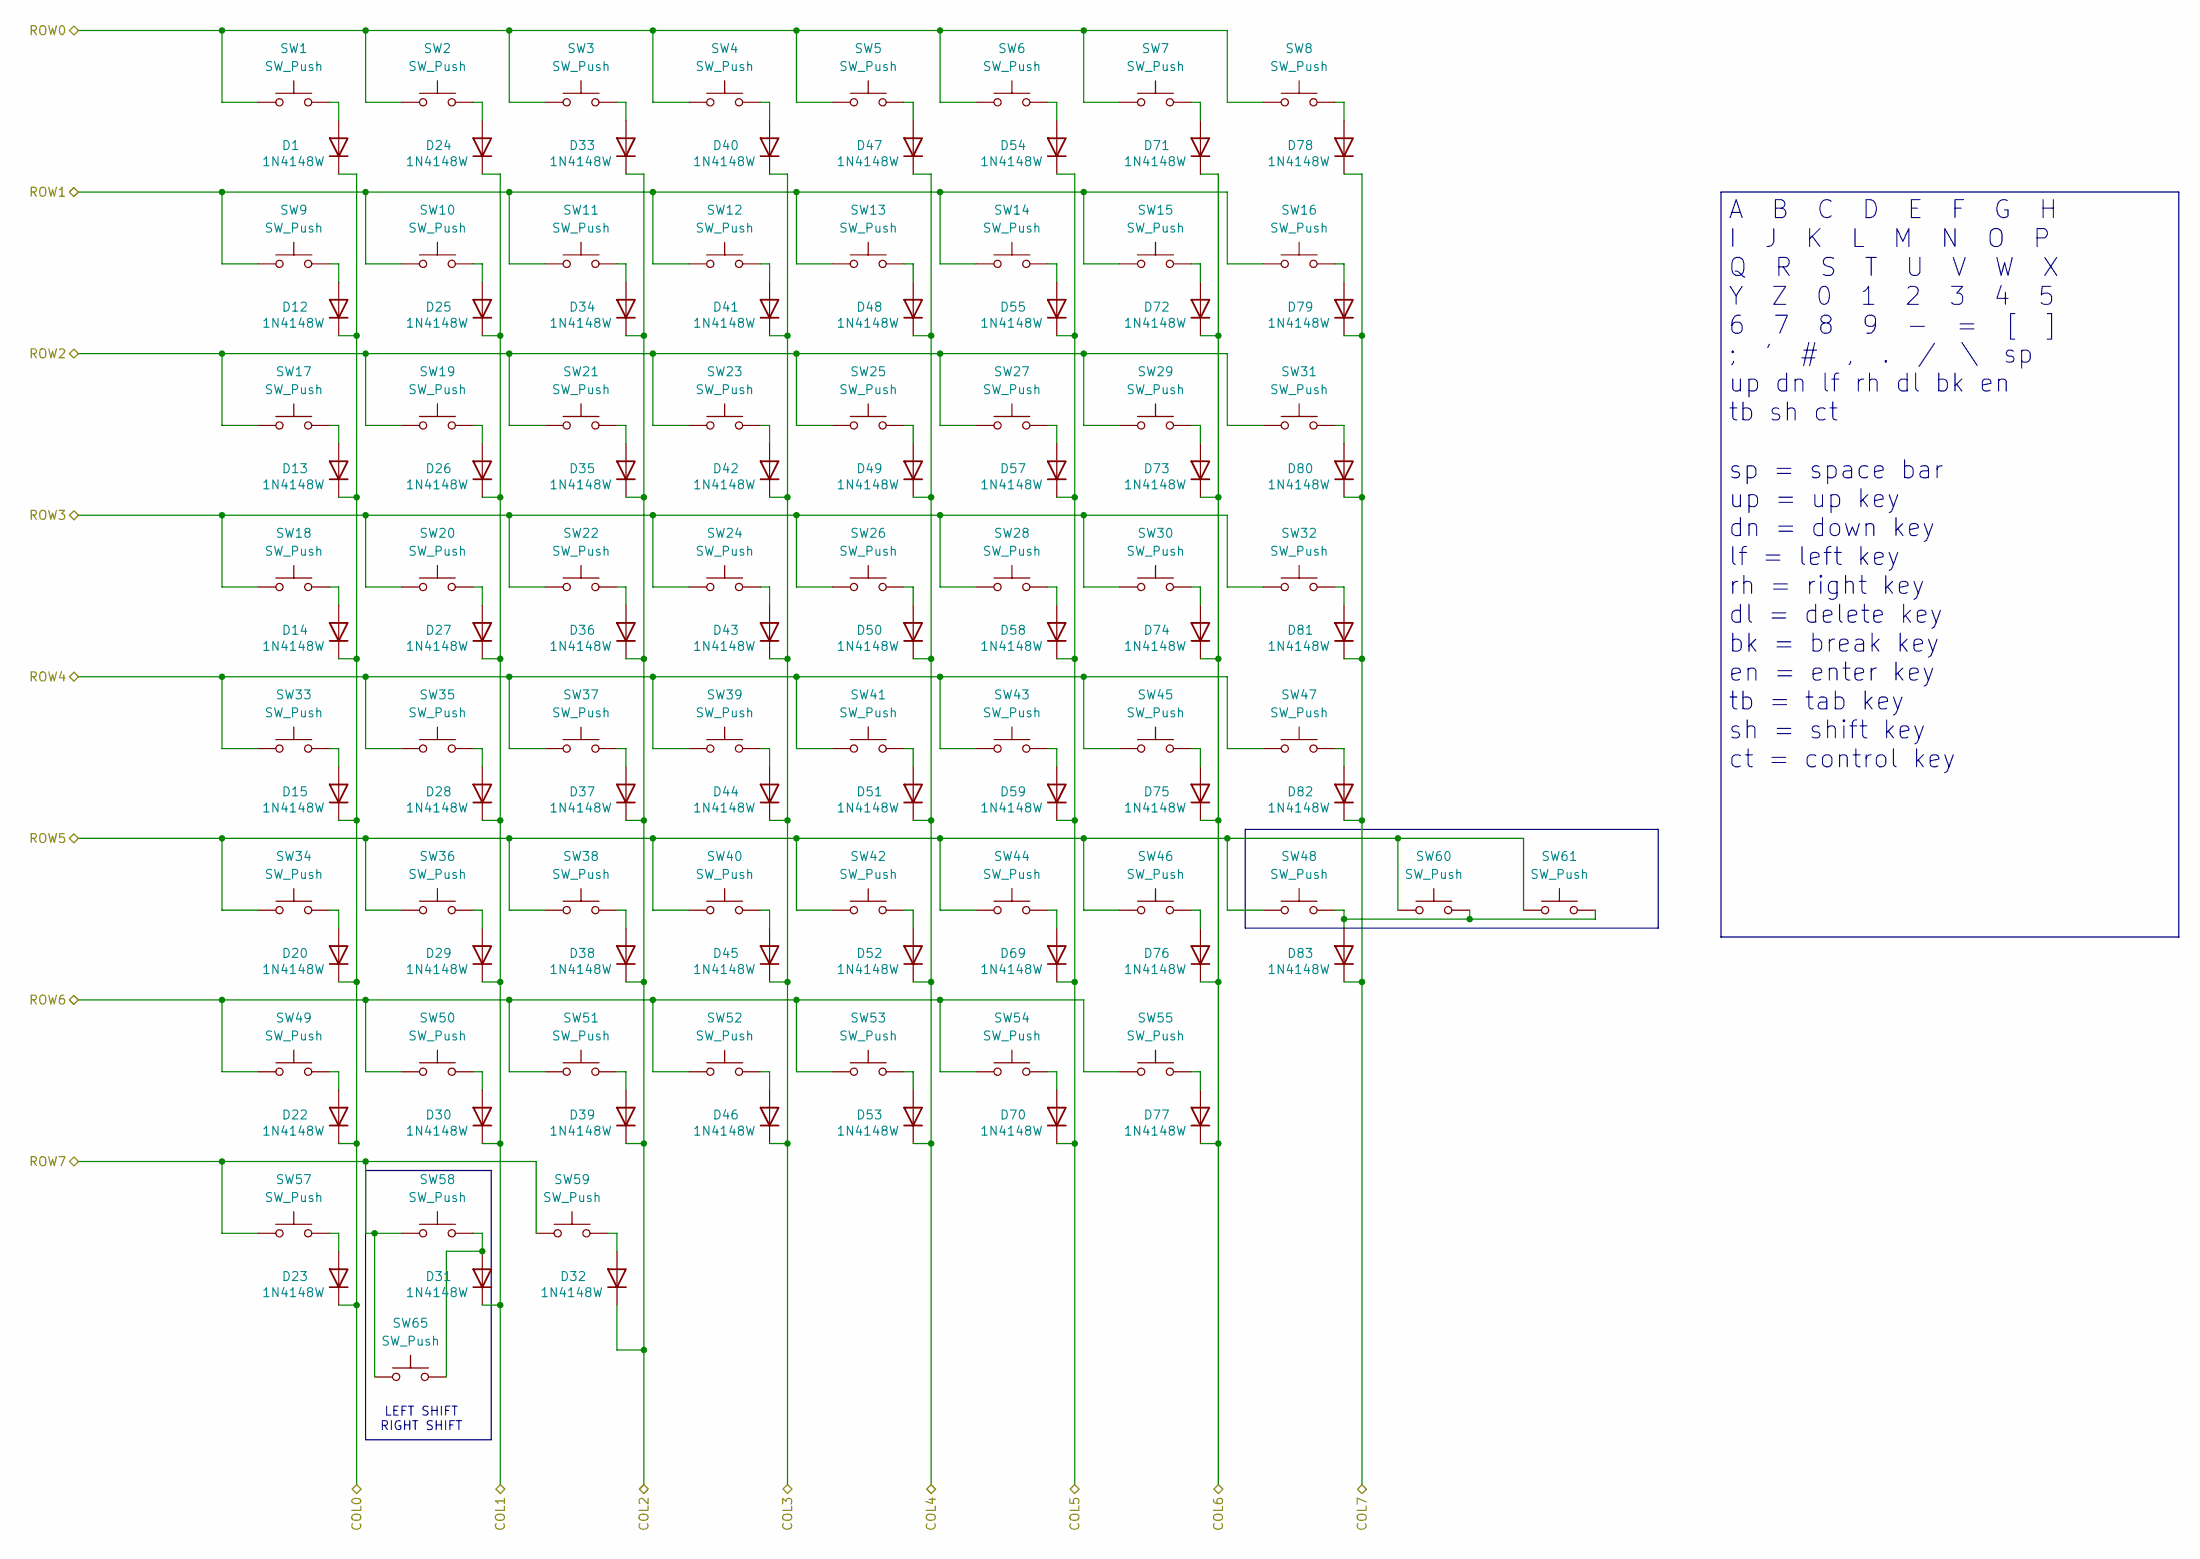
[picture p19: schematic KeyMatrix.kicad_sch]

Parts:
D1, D12, D13, D14, D15, D20, D22, D23, D24, D25, D26, D27, D28, D29, D30, D31, D32, D33, D34, D35, D36, D37, D38, D39, D40, D41, D42, D43, D44, D45, D46, D47, D48, D49, D50, D51, D52, D53, D54, D55, D57, D58, D59, D69, D70, D71, D72, D73, D74, D75, D76, D77, D78, D79, D80, D81, D82, D83: 1N4148W; D_SOD-123; LCSC C2099
SW1, SW2, SW3, SW4, SW5, SW6, SW7, SW8, SW9, SW10, SW11, SW12, SW13, SW14, SW15, SW16, SW17, SW18, SW19, SW20, SW21, SW22, SW23, SW24, SW25, SW26, SW27, SW28, SW29, SW30, SW31, SW32, SW33, SW34, SW35, SW36, SW37, SW38, SW39, SW40, SW41, SW42, SW43, SW44, SW45, SW46, SW47, SW48, SW49, SW50, SW51, SW52, SW53, SW54, SW55, SW57, SW58, SW59, SW60, SW61, SW65: SW_Push; SW_PG1350; LCSC DNF

Connections:
/Keyboard IF/KeyMatrix/COL0: D1.1 (K), D12.1 (K), D13.1 (K), D14.1 (K), D15.1 (K), D20.1 (K), D22.1 (K), D23.1 (K); also elsewhere on the board
/Keyboard IF/KeyMatrix/COL1: D24.1 (K), D25.1 (K), D26.1 (K), D27.1 (K), D28.1 (K), D29.1 (K), D30.1 (K), D31.1 (K); also elsewhere on the board
/Keyboard IF/KeyMatrix/COL2: D32.1 (K), D33.1 (K), D34.1 (K), D35.1 (K), D36.1 (K), D37.1 (K), D38.1 (K), D39.1 (K); also elsewhere on the board
/Keyboard IF/KeyMatrix/COL3: D40.1 (K), D41.1 (K), D42.1 (K), D43.1 (K), D44.1 (K), D45.1 (K), D46.1 (K); also elsewhere on the board
/Keyboard IF/KeyMatrix/COL4: D47.1 (K), D48.1 (K), D49.1 (K), D50.1 (K), D51.1 (K), D52.1 (K), D53.1 (K); also elsewhere on the board
/Keyboard IF/KeyMatrix/COL5: D54.1 (K), D55.1 (K), D57.1 (K), D58.1 (K), D59.1 (K), D69.1 (K), D70.1 (K); also elsewhere on the board
/Keyboard IF/KeyMatrix/COL6: D71.1 (K), D72.1 (K), D73.1 (K), D74.1 (K), D75.1 (K), D76.1 (K), D77.1 (K); also elsewhere on the board
/Keyboard IF/KeyMatrix/COL7: D78.1 (K), D79.1 (K), D80.1 (K), D81.1 (K), D82.1 (K), D83.1 (K); also elsewhere on the board
unnamed: D1.2 (A), SW1.2
unnamed: D12.2 (A), SW9.2
unnamed: D13.2 (A), SW17.2
unnamed: D14.2 (A), SW18.2
unnamed: D15.2 (A), SW33.2
unnamed: D20.2 (A), SW34.2
unnamed: D22.2 (A), SW49.2
unnamed: D23.2 (A), SW57.2
unnamed: D24.2 (A), SW2.2
unnamed: D25.2 (A), SW10.2
unnamed: D26.2 (A), SW19.2
unnamed: D27.2 (A), SW20.2
unnamed: D28.2 (A), SW35.2
unnamed: D29.2 (A), SW36.2
unnamed: D30.2 (A), SW50.2
unnamed: D31.2 (A), SW58.2, SW65.2
unnamed: D32.2 (A), SW59.2
unnamed: D33.2 (A), SW3.2
unnamed: D34.2 (A), SW11.2
unnamed: D35.2 (A), SW21.2
unnamed: D36.2 (A), SW22.2
unnamed: D37.2 (A), SW37.2
unnamed: D38.2 (A), SW38.2
unnamed: D39.2 (A), SW51.2
unnamed: D40.2 (A), SW4.2
unnamed: D41.2 (A), SW12.2
unnamed: D42.2 (A), SW23.2
unnamed: D43.2 (A), SW24.2
unnamed: D44.2 (A), SW39.2
unnamed: D45.2 (A), SW40.2
unnamed: D46.2 (A), SW52.2
unnamed: D47.2 (A), SW5.2
unnamed: D48.2 (A), SW13.2
unnamed: D49.2 (A), SW25.2
unnamed: D50.2 (A), SW26.2
unnamed: D51.2 (A), SW41.2
unnamed: D52.2 (A), SW42.2
unnamed: D53.2 (A), SW53.2
unnamed: D54.2 (A), SW6.2
unnamed: D55.2 (A), SW14.2
unnamed: D57.2 (A), SW27.2
unnamed: D58.2 (A), SW28.2
unnamed: D59.2 (A), SW43.2
unnamed: D69.2 (A), SW44.2
unnamed: D70.2 (A), SW54.2
unnamed: D71.2 (A), SW7.2
unnamed: D72.2 (A), SW15.2
unnamed: D73.2 (A), SW29.2
unnamed: D74.2 (A), SW30.2
unnamed: D75.2 (A), SW45.2
unnamed: D76.2 (A), SW46.2
unnamed: D77.2 (A), SW55.2
unnamed: D78.2 (A), SW8.2
unnamed: D79.2 (A), SW16.2
unnamed: D80.2 (A), SW31.2
unnamed: D81.2 (A), SW32.2
unnamed: D82.2 (A), SW47.2
unnamed: D83.2 (A), SW48.2, SW60.2, SW61.2
ROW0: SW1.1, SW2.1, SW3.1, SW4.1, SW5.1, SW6.1, SW7.1, SW8.1; also elsewhere on the board
ROW1: SW9.1, SW10.1, SW11.1, SW12.1, SW13.1, SW14.1, SW15.1, SW16.1; also elsewhere on the board
ROW2: SW17.1, SW19.1, SW21.1, SW23.1, SW25.1, SW27.1, SW29.1, SW31.1; also elsewhere on the board
ROW3: SW18.1, SW20.1, SW22.1, SW24.1, SW26.1, SW28.1, SW30.1, SW32.1; also elsewhere on the board
ROW4: SW33.1, SW35.1, SW37.1, SW39.1, SW41.1, SW43.1, SW45.1, SW47.1; also elsewhere on the board
ROW5: SW34.1, SW36.1, SW38.1, SW40.1, SW42.1, SW44.1, SW46.1, SW48.1, SW60.1, SW61.1; also elsewhere on the board
ROW6: SW49.1, SW50.1, SW51.1, SW52.1, SW53.1, SW54.1, SW55.1; also elsewhere on the board
ROW7: SW57.1, SW58.1, SW59.1, SW65.1; also elsewhere on the board

Notes on the sheet:
LEFT SHIFT RIGHT SHIFT
A B C D E F G H I J K L M N O P Q R S T U V W X Y Z 0 1 2 3 4 5 6 7 8 9 - = [ ] ; ' # , . / \ sp up dn lf rh dl bk en tb sh ct sp = space bar up = up key dn = down key lf = left key rh = right key dl = delete key bk = break key en = enter key tb = tab key sh = shift key ct = control key

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
Board: 4 copper layers, 396 parts (1 on the bottom side), 318 nets, no tracks yet.

Other parts of the board:
JP3: PD LED PWR; SolderJumper-3_P1.3mm_Bridged12_Pad1.0x1.5mm_NumberLabels

Their connections:
+3.3V: JP3.3 (B); also elsewhere on the board
