TechPaula/LT6502b/(commit log)

2026-02-22 Add models, add basic keyboard shape, update readme
    [18650 Battery.STEP, KeyMatrix.kicad_sch, Keybed_JLC_assembly_parts_bom.xls, LT6502b_KEYBED.kicad_sch, keyleds.kicad_sch]
2026-02-22 Add extra mounting holes
    [LT6502b_KEYBED.kicad_sch]
2026-02-22 Move holes a little more
2026-02-22 Added files from Fusion
    [Lower Case V9.step]
2026-02-22 Work on Main Board Schematic and new board shape
    [60FAKE50.kicad_sch, Audio.kicad_sch, CompactFlash.kicad_sch, DisplayConnector.kicad_sch, Expansion.kicad_sch, Glue_Addr.kicad_sch, KeyboardIF.kicad_sch, MainBoard.kicad_pcb]
2026-02-22 Updated USB wiring, moved key parts, increased board dimensions
    [60FAKE50.kicad_sch, DisplayConnector.kicad_sch, MainBoard.kicad_pcb]
2026-02-24 Move to a single board for everything (keyboard and main board)
    Aim is to save height
    [60FAKE50.kicad_sch, Expansion.kicad_sch, Glue_Addr.kicad_sch, KeyMatrix.kicad_sch, KeyboardIF.kicad_sch, MainBoard.kicad_sch, Modem.kicad_sch, keyleds.kicad_sch]
2026-02-24 rough placement of parts to help with 3D CAD
    [DisplayConnector.kicad_sch, Expansion.kicad_sch, KeyMatrix.kicad_sch, MainBoard.kicad_pcb]
2026-02-24 Work on parts placement, remove excess LEDs
    [MainBoard.kicad_pcb, Power.kicad_sch]
2026-02-26 Work on PCB
    [60FAKE50.kicad_sch, Audio.kicad_sch, CompactFlash.kicad_sch, DisplayConnector.kicad_sch, Expansion.kicad_sch, Glue_Addr.kicad_sch, KeyboardIF.kicad_sch, MainBoard.kicad_sch]
2026-02-27 Work on main board parts positions
2026-02-28 Work on PCB routing, added SwinSID
    [Audio.kicad_sch, DisplayConnector.kicad_sch, Glue_Addr.kicad_sch, KeyboardIF.kicad_sch, MainBoard.kicad_sch, nanoSwinSID.kicad_sch]
2026-03-01 Completed routing
    [Glue_Addr.kicad_sch, Power.kicad_sch, VIA.kicad_sch]
2026-03-07 Updates based on production files for JLC
    [60FAKE50.kicad_sch, Audio.kicad_sch, CompactFlash.kicad_sch, DisplayConnector.kicad_sch, Glue_Addr.kicad_sch, JLC_Selected_bom.xls, KeyMatrix.kicad_sch, KeyboardIF.kicad_sch]
2026-03-07 Added image of case in progress
2026-03-21 Add some comments to schematic, update README, start on GLUE
    Add some comments to schematic, update README, start on GLUE
    [60FAKE50.kicad_sch, Audio.kicad_sch, CompactFlash.kicad_sch, DisplayConnector.kicad_sch, Glue_Addr.kicad_sch, MainBoard.kicad_sch, MainBoard_full_BoM.xls, Power.kicad_sch]
2026-03-22 Work on revised firmware and CPLD
    [basic.cfg]
2026-03-22 Work on cpld
    CF now working,
    Seems to sometimes crash, unclear why at this stage, possibly a timing issue with console port.
2026-03-22 Add notes to GLUE logic page
    [Glue_Addr.kicad_sch]
